mickkn/E2PRJ2/Projektrapport/Master.tex

\input{preamble_ida14}
\raggedbottom
\begin{document}

\include{filer/Underskrifter}

% Resume

\include{filer/resume}

% English Abstract

\include{filer/abstract}

% Indledning

\tableofcontents*

\include{filer/indledning}

% Opgave formulering

\include{filer/opgaveformulering}

% Afgrænsniger i projektet

\include{filer/projektafgraensning}

% Systembeskrivelse

\include{filer/systembeskrivelse}

% Kravspec

\include{filer/krav}

% generelle krav for systemet 

\include{filer/kravspec}

% Arbejdsprocessen

\include{filer/arbejdsproces}

% Udviklingsværktøjer

\include{filer/udviklingsvaerktoejer}

% Systemarkitektur

\include{filer/systemarkitektur}

%  Design - sections af HW og SW

\include{filer/design}

% Implementering - sections af HW og SW

\include{filer/implementering}

% Resultater

\include{filer/resultater}

% Resultater

\include{filer/erfaringer}

% Opnåede erfaringer som gruppe

\include{filer/fremtidigtarbejde}

% Konklusion

\include{filer/konklusion}

% Individuel Konklusion

\include{filer/Individuelkonklusion}

% Individuel Konklusion

% Litteraturliste
\include{filer/litteraturliste}

% Billags-CD struktur
\include{filer/cdindhold}

\end{document}
