mickkn/E2PRJ2/Projektrapport/filer/HWimplementering.tex

\section{Hardware implementering}

% HW implementering

Encoder og decoder er bygget på veroboard\footnote{Billeder af begge veroboard ses under integrationstesten i dokumentationen, side 106} ud fra kredsløbsdiagrammerne. Knappen til babyalarmen er tilføjet på encoder printet. 18 Vac / 50 Hz udtaget med tilhørende relæ er tilføjet på decoderprintet.
