mickkn/E2PRJ2/Projektrapport/filer/HWdesign.tex

\section{Hardwaredesign}

% HW design
Generelt kan det overordnede hardwaredesign beskrives som noget elektronik der sender information ud på el-nettet og modtages samt analyseres af noget elektronik i den anden ende. Disse vil blive beskrevet herunder som encoder og decoder\footnote{For yderlige beregninger se projektdokumentation side 67-75}.  

\section{Encoder (JS)}
X10-encoderen, er en del af CSS hovedenheden. CSS-hovedenheden genererer X10-bitstrømmen og sender den ud på det eksisterende el-net. Encoderen består af et højpasfilter der lader 120 kHz burst passere mens det blokerer for nettets 50 Hz signal, og en zero crossing detector der detekterer nulgennemgang.

\begin{figure}[htbp]
	\centering
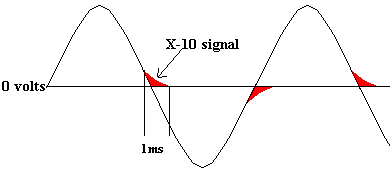
[picture p1: Projektrapport/Billeder/HWdesign/X10_BURST.png]
	
	\caption{120 kHz burst i zero crossing}
	\label{fig:X10_BURST}
\end{figure}

Ideen med at sende burst ud på nettet i zero crossing kan ses illustreret på figur \ref{fig:X10_BURST}

\begin{figure}[htbp]
	\centering
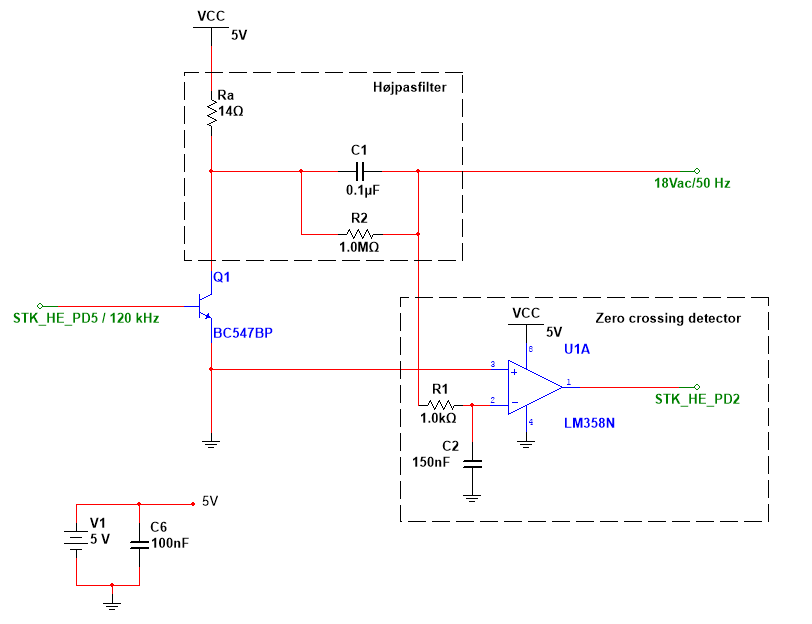
[picture p2: Projektrapport/Billeder/HWdesign/Encoder.PNG]
	
	\caption{Samlet Encoder}
	\label{fig:Encoder}
\end{figure}
\newpage

\subsection{Højpasfilter (JS)}

\begin{figure}[htb]
  \begin{minipage}{0.45\textwidth}
    \centering
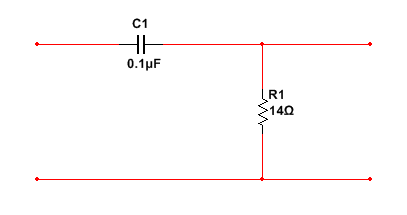
[picture p3: Projektrapport/Billeder/HWdesign/HP_MV.png]
      
      \caption{Højpasfilter med værdier}
    \label{fig:HP_MV}
  \end{minipage}
  \hspace{0.1\textwidth}
  \begin{minipage}{0.45\textwidth}
    \centering
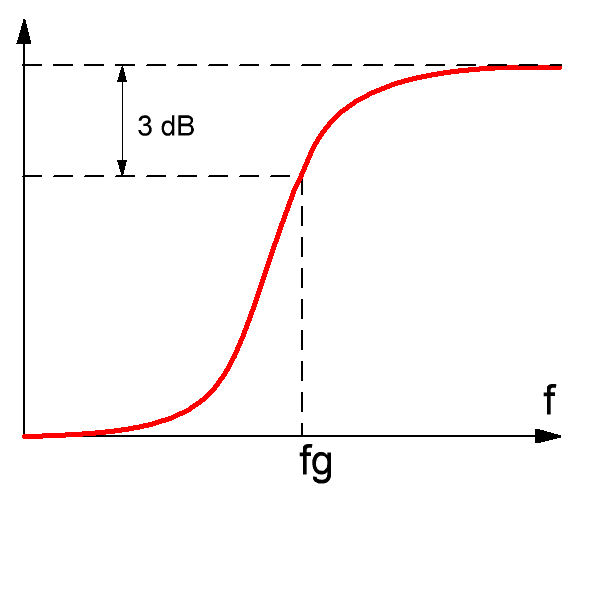
[picture p4: Projektrapport/Billeder/HWdesign/HP_KURVE.png]
      
      \caption{Kurvekarakteristik for højpasfilter}
    \label{fig:HP_KURVE}
  \end{minipage}
\end{figure}

For at sende X10 kommandoer ud på det eksisterende 50 Hz el-net er det nødvendigt at koble elektroniken direkte herpå og eftersom det elektronik ikke tåler de høje spændinger fra nettet, er det nødvendigt at blokere det signal, men stadig at kunne sende de 120 kHz ud. Dette løses med et højpasfilter.

Den ønskede knækfrekvens skal ligge omkring de 120 kHz for at opnå mindst dæmpning herpå. Ved denne knækfrekvens skulle 50 Hz signalet være ubetydelig lille efter filteret. 

Kondensatoren forudbestemmes via beregningerne til en værdi på 0,1 nF.

\newpage
  
\subsection{Zero Crossing Detector (SK)}
\begin{figure}[htb]
  \begin{minipage}{0.45\textwidth}
    \centering
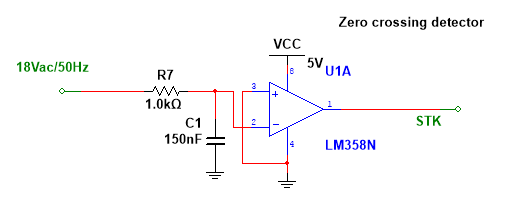
[picture p5: Projektrapport/Billeder/HWdesign/ZC_MV.PNG]
      
      \caption{Zero crossing detector med værdier}
    \label{fig:ZC_MV}
  \end{minipage}
  \hspace{0.1\textwidth}
  \begin{minipage}{0.45\textwidth}
    \centering
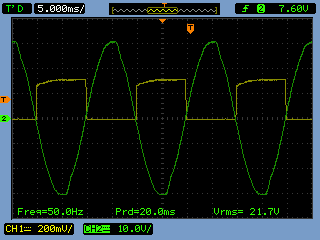
[picture p6: Projektrapport/Billeder/HWTest/Encoder/Encoder_zerocross.png]
      
      \caption{Scope billede af Zero crossing detector, CH1 (udgangssignal), CH2 (indgangssignal)}
    \label{fig:Encoder_Zerocross}
  \end{minipage}
\end{figure}

Zero crossing detectoren har til opgave at detektere nulgennemgang, det er et krav for at X10 protokollen kan virke. Der er placeret en zero crossing detector både på encoderen og decoderen, da begge disse består af et STK500-kit der kræver information om nulgennemgang. Opbygning kan ses på overstående figur \ref{fig:ZC_MV}, der er anvendt en operationsforstærker af typen LM358N, som toggler udgangssignalet ved hver nulgennemgang se figur \ref{fig:Encoder_Zerocross}. Operationsforstærkerens positive ben er koblet til stel for at lave et triggerniveau til 0 V.

Modstanden $R_7$ sidder der bl.a. for at beskytte zero crossing detectoren mod 18 Vac nettet, men sammen med kondensatoren udgør den også et lavpasfilter. Under implementeringen kunne det konstateres at der kom støj ind på zero crossing detectoren, og dette problem løste lavpasfilteret. 

Der ønskes at dæmpe 120 kHz signalet, derfor designes lavpasfilteret ud fra en knækfrekvens på 1,0 kHz.

\section{Decoder (JS)}
Decoderen, som er den del i systemet der omdanner burst fra encoderen til X10 kommando, er opbygget af et båndpasfilter, zero crossing detector og en envelope detector. I starten af kredsløbet sidder båndpasfilteret, og dette blokerer for el-nettet og forstærker 120 kHz signalet der kommer fra encoderen. Herefter ledes signalet gennem envelope detector som omdanner burstet til et TTL signal.

\begin{figure}[htbp]
	\centering
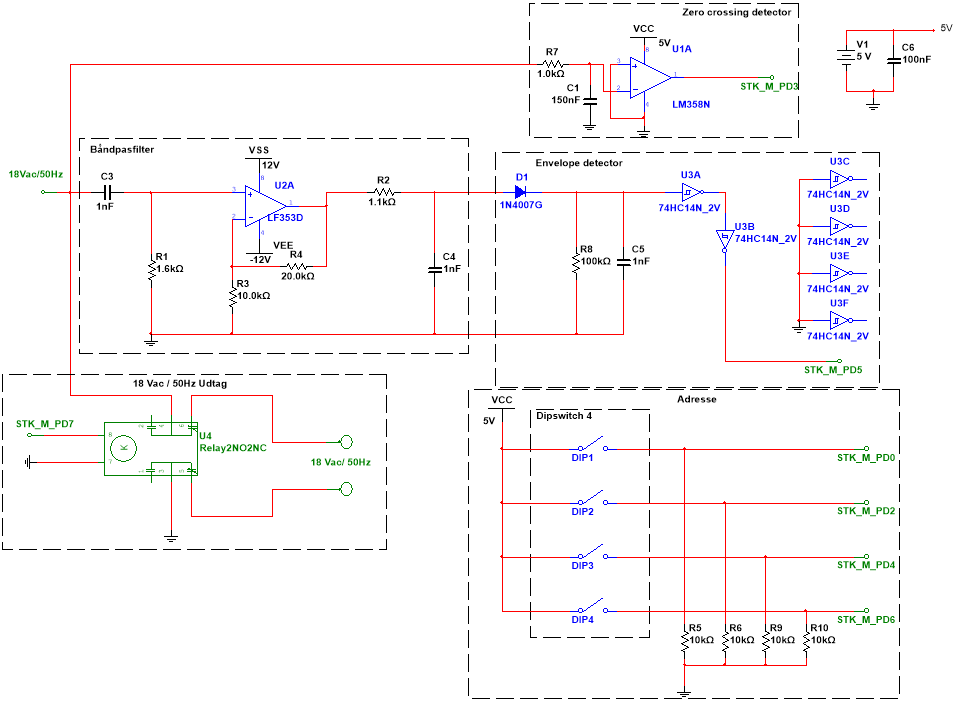
[picture p7: Projektrapport/Billeder/HWdesign/Decoder.PNG]
	
	\caption{Samlet Decoder}
	\label{fig:Decoder}
\end{figure}

\newpage

\subsection{Båndpasfilter (JS)}

\begin{figure}[htb]
  \begin{minipage}{0.45\textwidth}
    \centering
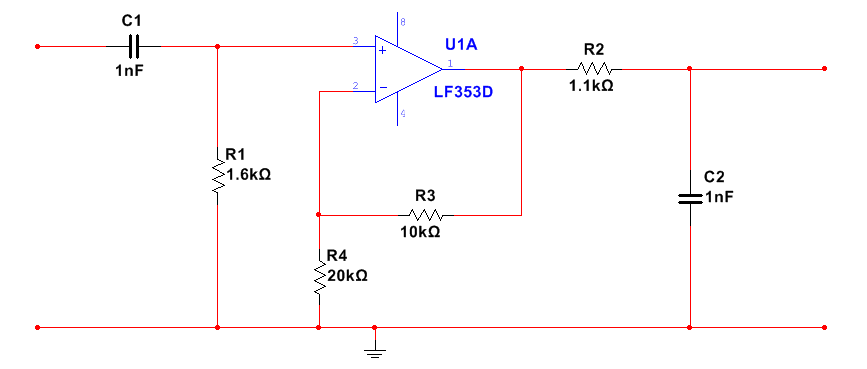
[picture p8: Projektrapport/Billeder/HWdesign/BAANDPAS_MV.PNG]
      
      \caption{Båndpasfilter med værdier}
    \label{fig:BAANDPAS_MV}
  \end{minipage}
  \hspace{0.1\textwidth}
  \begin{minipage}{0.45\textwidth}
    \centering
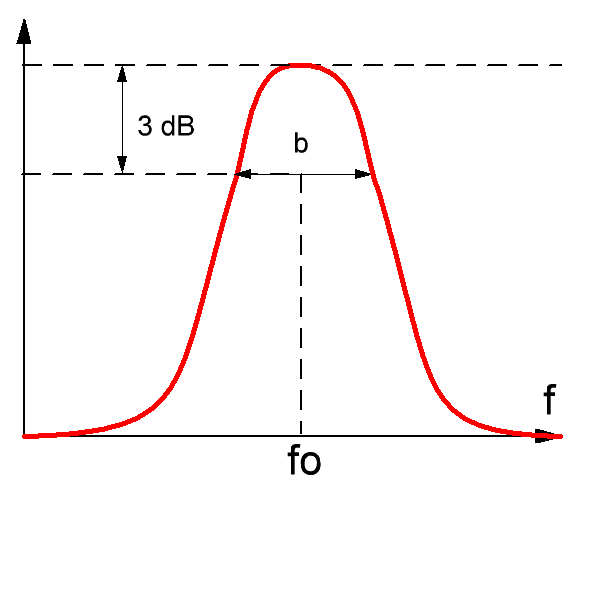
[picture p9: Projektrapport/Billeder/HWdesign/BAANDPAS_KURVE.png]
      
      \caption{Kurvekarakteristik for båndpasfilter}
    \label{fig:BAANDPAS_KURVE}
  \end{minipage}
\end{figure}

Båndpasfilteret har til opgave at filtrere alle signaler med frekvenser over og under 120 kHZ fra samtidig med at det forstærker signalet i båndpasset. Forstærkningen opnås ved at koble en ikke inverterende operationsforstærker med modstande forbundet på tilbagekoblingen, hvis størrelse afhænger af den ønskede forstærkning, mellem et højpasfilter og lavpasfilter som illustreret på figur \ref{fig:BAANDPAS_MV}. Kurvekarakteristikken er illustreret på figur \ref{fig:BAANDPAS_KURVE}.

Da vi ønsker at forstærke 120 kHz signalet, designes højpasfilteret således at knækfrekvensen udregnes til 110 kHz, og for lavpasfilteret beregnes en knækfrekvens til 130 kHz.

\subsection{Envelope Detector (SK)}
\begin{figure}[htbp]
	\centering
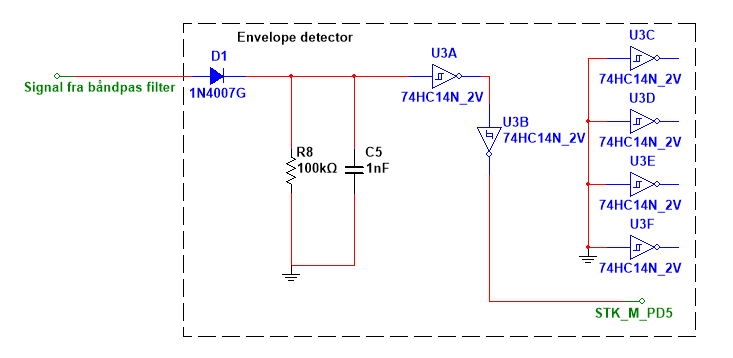
[picture p10: Projektrapport/Billeder/HWdesign/ED_MV.PNG]
	
	\caption{Envelope detector}
	\label{fig:ED_MV}
\end{figure}

Envelope detectorens opgave er at udglatte burstsignalet fra båndpasfilteret og lave det om til et TTL signal som STK500 kan aflæse.

Den er opbygget af en diode, et RC-led og en schmitt-trigger. Dioden har til opgave at sortere alle de negative halvperioder fra og kun sende de positive halvperioder til RC-leddet. Kondensatoren vil derfor kun opfange de positive halvperioder. Kondensatoren er med til at udglatte signalet da den ikke kan nå at aflades på en periode.

Modstanden $R_8$ er en afladnings modstand, og den bestemmer hvor hurtigt kredsløbet skal aflades, jo højere modstand jo langsommere går det med at aflade.

Der er anvendt en schmitt-trigger til at lave signalet om til et firkantet signal som STK500 kan aflæses. Grunden til at der er brugt 2 er fordi de er inverterende.

\newpage
\subsection{Dipswitch (JS)}
For at en X10-kommando bliver udført af det korrekte udtag medsendes en adresse på fire bit.
Til at angive den korrekte adresseringen for et udtag, er der lavet fire dipswitches der er forsynet med 5 V og forbundet til STK500 på X10-udtaget, som det er illustreret på figur \ref{fig:DIPSWITCH}.

En åben kontakt vil give LAV(0V) og en lukket kontakt vil resultere i HØJ(5V)

\begin{figure}[htbp]
	\centering
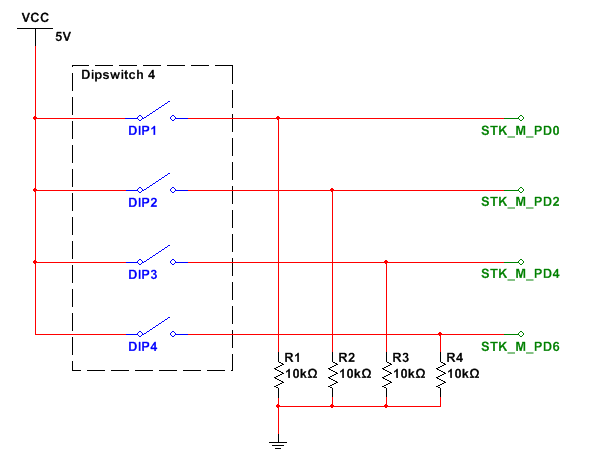
[picture p11: Projektrapport/Billeder/HWdesign/DIPSWITCH.PNG]
	
	\caption{Dipswitch for adressering af X10-udtag}
	\label{fig:DIPSWITCH}
\end{figure}
