mickkn/E2PRJ2/Projektrapport/filer/krav.tex

\chapter{Krav (JS)}
Child Security System er et system vi har udviklet med udgangspunkt i at gøre den almindelige husstand mere sikker for børn. Samtidig skal systemet have en integreret baby overvågning som er tiltænkt som erstatning for den almindelige babyalarm.
Via en hovedenhed styres udvalgte enheder, hvorfra disse kan slukkes og tændes. Disse enheder er almindelige 230 V udtag som ønskes at kunne afbrydes eller styre en magnetlås til aflåsning af døre eller skuffer.

Baby overvågningen består af en sensor der måler lydniveauet i et rum som sender et signal til hovedenheden hvis grænseværdien overskrides. Dette signal fortæller hovedenheden at den skal sende en SMS til et telefonnummer efter kundens ønske.
