mickkn/E2PRJ2/Projektdokumentation/filer/ordliste.tex

\chapter{Ordliste}

\begin{description}

\item[AC] Alternating Current (Vekselstrøm)
\item[API] Application Programming Interface (Softwaregrænseflade til SMS kommunikation)
\item[Carriage return] ASCII kommando for at returnerer cursoren. (Kommunikations protokollerne som ETX)
\item[CSS] Child Security System (Børnesikkerheds System)
\item[ETX] End of text (Seriel kommunikation)
\item[HMI] Human Machine Interface (Brugergrænseflade man kan interagere med)
\item[ISR] Interrupt Service Rutine (Microcontroller funktions kald i tilfælde af et interrupt signal)
\item[RS232] Recommended Standard 232 (Seriel digital datakommunikation)
\item[STK500] Atmel Mega32 development board
\item[STX] Start of text (Seriel kommunikation)
\item[UART] Universal Asynchronous Receiver/Transmitter
\item[UC] Use Case
\item[UI] User Interface (Brugergrænseflade)
\item[URL] Uniform resource locator (Adresse til internet resource)
\item[VAC] Volt Alternating Current (Vekselstrøm)
\item[X10] Kommunikationsprotokol over el-nettet

\end{description}
