mickkn/E2PRJ2/Projektdokumentation/filer/kravspec.tex

\chapter{Kravspecifikation}

\begin{table}[!htbp] \centering
\begin{tabular}{|p{2cm}|p{8cm}|}
	\hline
		\multicolumn{2}{|l|}{Versionshistorik} \\\hline
		\textbf{v1.2} &25-05-2014 Rettet ifm. accepttest\\\hline	
		\textbf{v1.1} &19-05-2014 Indledning + DE2 som aktør\\\hline
		\textbf{v1.0} &24-03-2014 Hele gruppen (efter 1. review)\\\hline
		\textbf{v0.5} &20-03-2014 Hele gruppen\\\hline
	\end{tabular}
\end{table}

\input{filer/indledning}

\begin{figure}[htbp] \centering
\section{Aktører}
\fbox{}
\caption{Kontekst diagram}
\label{lab:kontekstdiagram}
\end{figure}

\begin{table}[!htbp] \centering
\subsection{Bruger}
\begin{tabular}{|p{4cm}|p{8cm}|}
	\hline
		\textbf{Type Beskrivelse} &
			Bruger-aktøren er ejeren af systemet eller den voksne med adgang til PCen. 
			Vil typisk være forældre, barnepige osv. (Primær) \\\hline
	\end{tabular}
\end{table}

\begin{table}[!htbp] \centering
\subsection{Eksterne enheder}
\begin{tabular}{|p{4cm}|p{8cm}|}
	\hline
		\textbf{Type Beskrivelse} &
			Eksterne enheder, omfatter hvad man ønsker at aflåse eller slukke for. 
			Vil typisk være skabe, komfur, el-kedel osv. (Sekundær) \\\hline
	\end{tabular}
\end{table}

\begin{table}[!htbp] \centering
\subsection{Barn}
\begin{tabular}{|p{4cm}|p{8cm}|}
	\hline
		\textbf{Type Beskrivelse} &
			Barnet eller børnene i huset, som systemet skal beskytte.	(Sekundær) \\\hline
	\end{tabular}
\end{table}

\begin{table}[!htbp] \centering
\subsection{SMS-modtager}
\begin{tabular}{|p{4cm}|p{8cm}|}
	\hline
		\textbf{Type Beskrivelse} &
			Typisk forældrene eller barnepigen. Den person der skal have besked om gråd eller anden støj fra børneværelset. (Sekundær) \\\hline
	\end{tabular}
\end{table}

\begin{table}[!htbp] \centering
\subsection{DE2-board}
\begin{tabular}{|p{4cm}|p{8cm}|}
	\hline
		\textbf{Type Beskrivelse} &
			DE2-board programmeret som kodelås i DSD øvelse 7 (Sekundær) \\\hline
	\end{tabular}
\end{table}

\begin{figure}[!htbp] \centering
\section{Usecases}
\vspace*{\fill}

\caption{Usecase diagram}
\label{lab:usecasediagram}
\vspace*{\fill}
\end{figure}

\clearpage

% UC1: Login

\subsection{UC1: Login}
\input{filer/kravspec/uc1}

% UC2: Aktiver

\subsection{UC2: Aktiver}
\input{filer/kravspec/uc2}

% UC3: Deaktiver

\subsection{UC3: Deaktiver}
\input{filer/kravspec/uc3}

% UC4: Udlæs status

\subsection{UC4: Udlæs status}
\input{filer/kravspec/uc4}

% UC5: Detekter lyd

\subsection{UC5: Detekter lyd}
\input{filer/kravspec/uc5}

% UC6: Rediger SMS-modtager

\subsection{UC6: Rediger SMS-modtager}
\input{filer/kravspec/uc6}

% UC7: Startopsætning

\subsection{UC7: Startopsætning}
\input{filer/kravspec/uc7}

% UC8: Tilføj/fjern X10 udtag

\subsection{UC8: Tilføj/fjern X10 udtag}
\input{filer/kravspec/uc8}

%% Ikke-funktionelle krav

\section{Ikke-funktionelle krav}
\input{filer/kravspec/ikkefunktionellekrav}

%% Begrænsninger

\section{Begrænsninger} \label{sectionBegraensninger}
\begin{itemize}
	\item Prototypen udføres i et 18 Vac testmiljø
	\item I stedet for magnetlåse til at simulere låsemekanismen bruges en lysindikator
	\item Protypen udføres med et STK500-kit, hvorfor krav til dimensionerne frafalder
\end{itemize}

\newpage
\section{HMI(Human Machine Interface)}

Billederne er inverteret for læsbarhedens skyld.

\begin{figure}[H] \centering
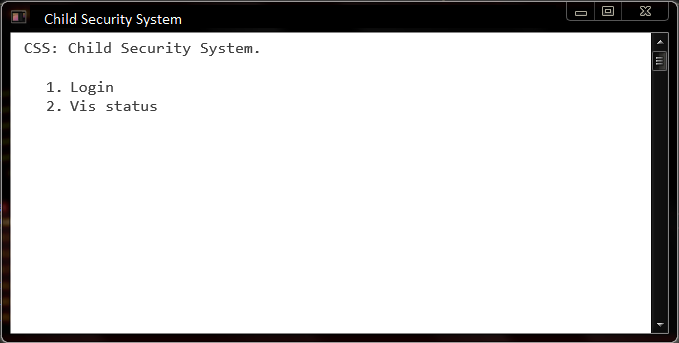
[picture p19: Projektdokumentation/billeder/cmdprompt/CSS_pre_login_menu.png]
{}
\caption{CSS Login skærm}
%\label{fig:CSS Login}
\end{figure}

\begin{figure}[H] \centering
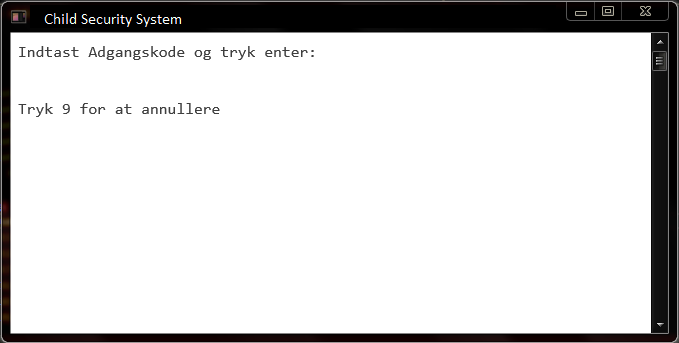
[picture p20: Projektdokumentation/billeder/cmdprompt/CSS_login.png]
{}
\caption{CSS Login}
%\label{fig:CSS Login}
\end{figure}

\begin{figure}[H] \centering
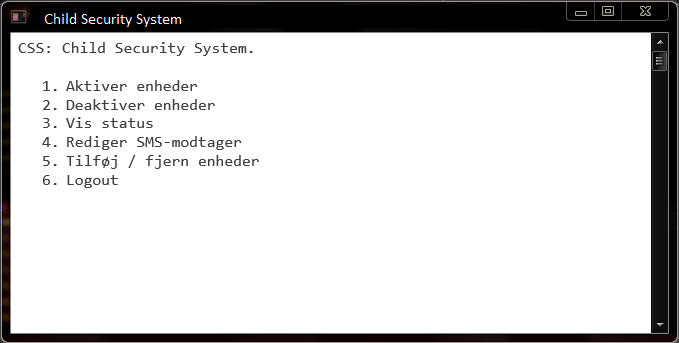
[picture p21: Projektdokumentation/billeder/cmdprompt/CSS_menu.png]
{}
\caption{CSS Menu}
%\label{lab:CSS Menu}
\end{figure}

\begin{figure}[H] \centering
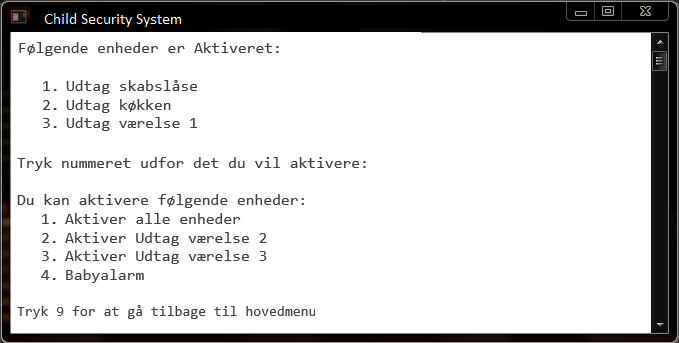
[picture p22: Projektdokumentation/billeder/cmdprompt/CSS_aktiver.png]
{}
\caption{CSS Aktiver}
%\label{fig:CSS Aktiver}
\end{figure}

\begin{figure}[H] \centering
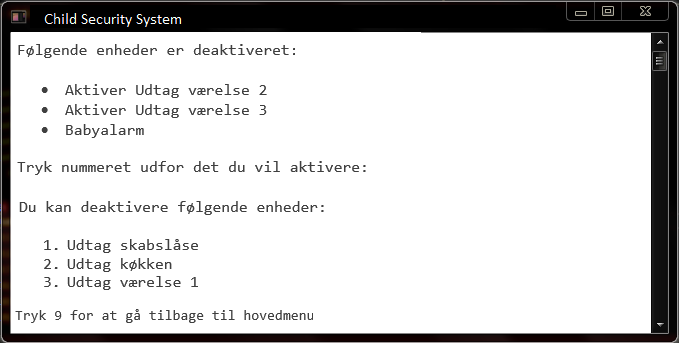
[picture p23: Projektdokumentation/billeder/cmdprompt/CSS_deaktiver.png]
{}
\caption{CSS Deaktvier}
%\label{fig:CSS Deaktvier}
\end{figure}

\begin{figure}[H] \centering
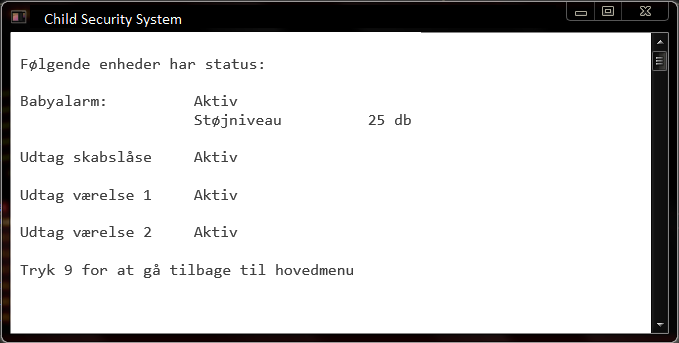
[picture p24: Projektdokumentation/billeder/cmdprompt/CSS_vis_status.png]
{}
\caption{CSS Udlæs status}
%\label{fig:CSS Vis Status}
\end{figure}

\begin{figure}[H] \centering
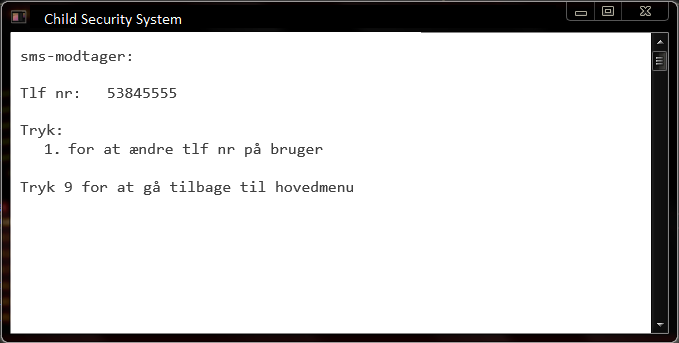
[picture p25: Projektdokumentation/billeder/cmdprompt/CSS_advisering.png]
{}
\caption{CSS Advisering}
%\label{fig:CSS Advisering}
\end{figure}
