mickkn/E2PRJ2/Projektdokumentation/filer/accepttest/atuc5.tex

%%% Tabel opsætning + Headernavn!!

\begin{center}
\begin{longtable}{|p{0,5cm}|p{3,8cm}|p{3,8cm}|p{2,2cm}|p{2,2cm}|} % l for left, c for center, r for right 
\hline
\multicolumn{5}{|l|}{\textbf{UC5: Detekter lyd}} \\ \hline
\multicolumn{1}{|c|}{} &
\textbf{Test} &
\textbf{Forventet \newline Resultat} &
\textbf{Resultat} &
\textbf{Godkendt/ \newline Kommentar} \\ \hline 
\endfirsthead

\multicolumn{5}{l}{...fortsat fra forrige side} \\ \hline 
\multicolumn{1}{|c|}{} &
\textbf{Test} &
\textbf{Forventet \newline Resultat} &
\textbf{Resultat} &
\textbf{Godkendt/ \newline Kommentar} \\ \hline 
\endhead

%%%% Tabel Opsætning

\textbf{1}		
&Lyddetektor er aktiveret
&Lyddetektor er aktiv	
&Ikke \newline testbart
&Ikke \newline godkendt \\\hline
\textbf{2}		
&Kontinuerligt lyd efterlignes	
&Detektorer opfanger lyd
&Ikke \newline testbart
&Ikke \newline godkendt \\\hline
\textbf{3}		
&Systemet underrettes	
&Systemet modtager signal fra lyddetektor 
&Som \newline forventet	
&Godkendt \newline vha. test kontakt  \\\hline
\textbf{4}		
&Systemet afsender SMS
&SMS-modtager modtager SMS fra systemet
&Som \newline forventet	
&Godkendt  \\\hline
	\end{longtable}
	%\caption{•}
	\label{ATUC5} 
\end{center}

%\begin{table}[htbp] \centering
%\begin{tabular}{|p{1,7cm}|p{2,3cm}|p{3cm}|p{3cm}|p{3cm}|} % l for left, c for center, r for right 
%	\hline
%\multicolumn{5}{|l|}{\textbf{UC7: Advisering}} \\\hline
%&\textbf{Test} &\textbf{Forventet \newline Resultat} &\textbf{Resultat} &\textbf{Godkendt/ \newline Kommentar} \\\hline
%\textbf{Punkt 1}		&Advisering vælges i interface	&Advisering screen kommer frem på skærmen 	&N/A 	&N/A \\\hline
%\textbf{Punkt 2}		&Der indtastes ændringer	og bekræftes		&Oplysningerne lagers i systemet og brugeren bliver sendt tilbage til menuen 	&N/A 	&N/A \\\hline
%	\end{tabular}
%	%\caption{•}
%	\label{ATUC7} 
%\end{table}
