mickkn/E2PRJ2/Projektdokumentation/filer/forundersoegelse/Laas.tex

\begin{table}[!h] \centering	
	\label{tab:laas1}
\begin{tabular}{|p{6cm}|p{8cm}|}
	\hline
		\textbf{Løsning}				&Elektrisk karm-lås TFS-A21 \\ \hline
		\textbf{Producent} 			&Ukendt \\ \hline
		\textbf{Tilslutning} 		&12VDC - 0.6A \\ \hline
		\textbf{Beskrivelse} 		&Elektrisk karm-lås med bevægelig pal \\ \hline
		\textbf{Krav} 				&Skal monteres med slutblæk \\ \hline
		\textbf{Fordele}				& \\ \hline
		\textbf{Ulemper} 			&Slutstykket begrænser montering (udfræsning). Den bevægelige pal skal smøres. \\ \hline
		\textbf{Pris} 				&65 kr \\ \hline
		\textbf{Link} 				&http://goo.gl/SDvjkd \\ \hline	
		\multicolumn{2}{|c|}{
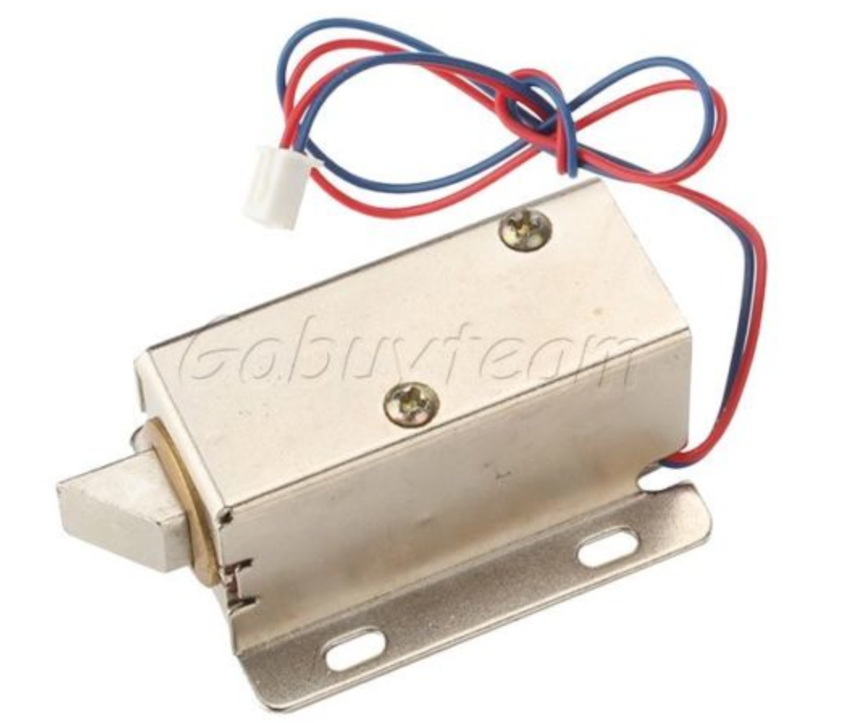
[picture p32: Projektdokumentation/billeder/TFS-A21.png]
			\raisebox{-0.91\height}{}} \\ \hline	
\end{tabular}
\end{table}

\begin{table}[!h] \centering
	\label{tab:laas2}
\begin{tabular}{|p{6cm}|p{8cm}|}
	\hline
		\textbf{Løsning}				&Elektromagnetisk lås 60kg \\ \hline
		\textbf{Producent} 			&KingGo \\ \hline
		\textbf{Tilslutning} 		&12 V DC - 0.3A\\ \hline
		\textbf{Beskrivelse} 		&Elektromagnetisk lås uden bevægelige dele \\ \hline
		\textbf{Krav} 				&Skal monteres med metalstykke \\ \hline
		\textbf{Fordele}				&Skal kun skrues fast \\ \hline
		\textbf{Ulemper} 			& \\ \hline
		\textbf{Pris} 				&115 kr \\ \hline
		\textbf{Link} 				&http://goo.gl/ewKYfa\\ \hline	
		\multicolumn{2}{|c|}{ 
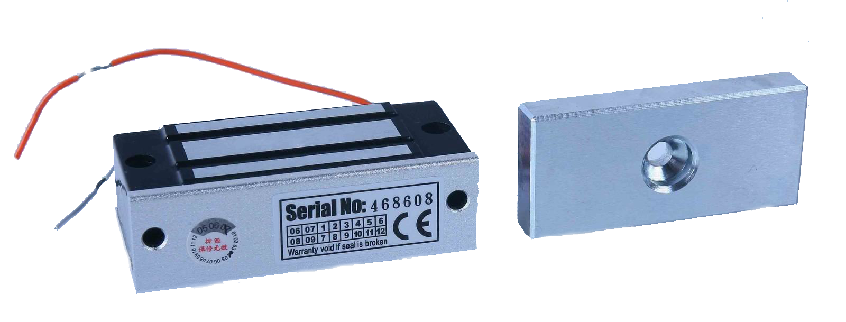
[picture p33: Projektdokumentation/billeder/magnetic.png]
			\raisebox{-0.91\height}{}} \\ \hline	
\end{tabular}
\end{table}
