mickkn/E2PRJ2/Projektdokumentation/filer/accepttest/accepttest.tex

\chapter{Accepttestspecifikation}

\begin{table}[!htbp] \centering
\begin{tabular}{|p{2cm}|p{8cm}|}
	\hline
		\multicolumn{2}{|l|}{Versionshistorik} \\ \hline
		\textbf{v1.0} &25-05-2014 Rettet ifm. med accepttest \\ \hline
		\textbf{v1.0} &24-03-2014 Hele gruppen (efter 1. review) \\ \hline
		\textbf{v0.5} &20-03-2014 Hele gruppen \\ \hline
	\end{tabular}
\end{table}

Punkterne i Accepttestspecifikationen, er skrevet ud fra punkterne i hovedforløbet, for de enkelte usecases.
Ved udførsel af accepttesten, bør UC\ref{ATUC7} laves først.

% Accepttest Use Case 1
\input{filer/accepttest/atuc1}

% Accepttest Use Case 2
\input{filer/accepttest/atuc2}

% Accepttest Use Case 3
\input{filer/accepttest/atuc3}

% Accepttest Use Case 4
\input{filer/accepttest/atuc4}

% Accepttest Use Case 5
\input{filer/accepttest/atuc5}

% Accepttest Use Case 6
\input{filer/accepttest/atuc6}

% Accepttest Use Case 7
\input{filer/accepttest/atuc7}

% Accepttest Use Case 8
\input{filer/accepttest/atuc8}

% Accepttest af ikke-funktionelle krav
\input{filer/accepttest/atikkefunktionellekrav}
