mickkn/E2PRJ2/Projektdokumentation/filer/forundersoegelse/Babyalarm.tex

\begin{table}[!h] \centering	
	\label{tab:baby1}
\begin{tabular}{|p{6cm}|p{8cm}|}
	\hline
		\textbf{Navn}				&Philips SCD505 \\ \hline
		\textbf{Rækkevidde} 			&330 \\ \hline
		\textbf{Lyd:} 				&Justerbar lydniveau. 
									Lys i forældreenheden angiver lydniveau ved babyen \\ \hline
		\textbf{Batteri} 		&Delvist genopladelig \\ \hline
		\textbf{Stråling} 				&Høj \\ \hline
		\textbf{Pris} 				&549 kr \\ \hline
		\textbf{Link} 				&http://goo.gl/pw06P9 \\ \hline	
		\multicolumn{2}{|c|}{
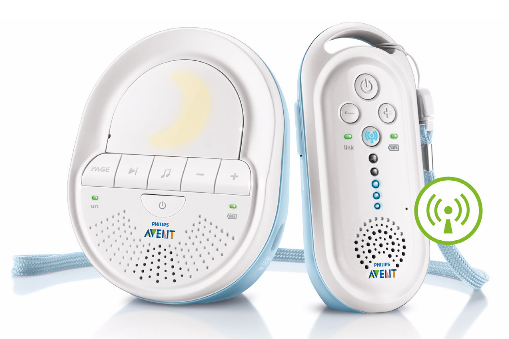
[picture p34: Projektdokumentation/billeder/SCD505.png]
			\raisebox{-0.91\height}{}} \\ \hline	
\end{tabular}
\end{table}

\begin{table}[!htbp] \centering
	\label{tab:baby2}
\begin{tabular}{|p{6cm}|p{8cm}|}
	\hline
		\textbf{Navn}				&Supernova D7 \\ \hline
		\textbf{Rækkevidde} 			&600m \\ \hline
		\textbf{Lyd} 		&Ukendt\\ \hline
		\textbf{Batteri} 		&2 genopladelige batterier \\ \hline
		\textbf{Pris} 				&999 kr \\ \hline
		\textbf{Stråling} 				&Lav \\ \hline
		\textbf{Link} 				&http://goo.gl/JFZcf5\\ \hline	
		\multicolumn{2}{|c|}{
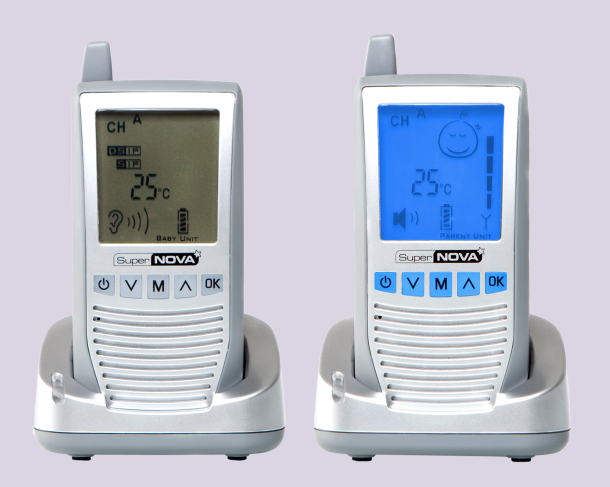
[picture p35: Projektdokumentation/billeder/Supernova.png]
			\raisebox{-0.91\height}{}} \\ \hline	
\end{tabular}
\end{table}
