mickkn/E2PRJ2/Projektdokumentation/filer/accepttest/atuc3.tex

%%% Tabel opsætning + Headernavn!!

\begin{center}
\begin{longtable}{|p{0,5cm}|p{3,8cm}|p{3,8cm}|p{2,2cm}|p{2,2cm}|} % l for left, c for center, r for right 
\hline
\multicolumn{5}{|l|}{\textbf{UC3: Deaktiver}} \\ \hline
\multicolumn{1}{|c|}{} &
\textbf{Test} &
\textbf{Forventet \newline Resultat} &
\textbf{Resultat} &
\textbf{Godkendt/ \newline Kommentar} \\ \hline 
\endfirsthead

\multicolumn{5}{l}{...fortsat fra forrige side} \\ \hline 
\multicolumn{1}{|c|}{} &
\textbf{Test} &
\textbf{Forventet \newline Resultat} &
\textbf{Resultat} &
\textbf{Godkendt/ \newline Kommentar} \\ \hline 
\endhead

%%%% Tabel Opsætning

\textbf{1}			&Bruger vælger ''Deaktiver'' i hovedmenu															
					&UI fortsætter til Punkt 2 (''Deaktiver menu'')
					&Som \newline forventet
					&Godkendt \\\hline
					
\textbf{2}			&Visuel test: Visning af ''Deaktiver menu''																
					&UI viser ''Deaktiver menu''
					&Som \newline forventet
					&Godkendt \\\hline

\textbf{3}			&''Deaktiver'' vælges			
					&UI fortsætter til Punkt 5 (Deaktivering)
					&Som \newline forventet
					&Godkendt \\\hline
					
\textbf{3a}			&''Tilbage'' vælges			
					&Fortsætter til Punkt 7 (Viser hovedmenu)
					&Som \newline forventet
					&Godkendt \\\hline

\textbf{4}			&Deaktivering			
					&Valgte enheder måles deaktiveret
					&Ikke \newline testbart 
					&Ikke \newline godkendt  \\\hline
		
\textbf{5}			&Visuel test: Viser besked om at enheder er deaktiverede
					&UI viser besked
					&Som \newline forventet
					&Godkendt \\\hline
					
\textbf{6}			&Visuel test: Viser hovedmenu
					&UI viser hovedmenu
					&Som \newline forventet
					&Godkendt \\\hline
					
%\textbf{Version}		&\multicolumn{4}{l|}{1.1} \\ \hline

	\end{longtable}
	%\caption{•}
	\label{ATUC3} 
\end{center}
