mickkn/E2PRJ2/Projektdokumentation/filer/accepttest/atuc4.tex

%%% Tabel opsætning + Headernavn!!

\begin{center}
\begin{longtable}{|p{0,5cm}|p{3,8cm}|p{3,8cm}|p{2,2cm}|p{2,2cm}|} % l for left, c for center, r for right 
\hline
\multicolumn{5}{|l|}{\textbf{UC4: Udlæs status}} \\ \hline
\multicolumn{1}{|c|}{} &
\textbf{Test} &
\textbf{Forventet \newline Resultat} &
\textbf{Resultat} &
\textbf{Godkendt/ \newline Kommentar} \\ \hline 
\endfirsthead

\multicolumn{5}{l}{...fortsat fra forrige side} \\ \hline 
\multicolumn{1}{|c|}{} &
\textbf{Test} &
\textbf{Forventet \newline Resultat} &
\textbf{Resultat} &
\textbf{Godkendt/ \newline Kommentar} \\ \hline 
\endhead

%%%% Tabel Opsætning

\textbf{1} 
&Vælger ''Udlæs status'' 
&UI fortsætter til Punkt 2 (Status vises) 
&Som \newline forventet
&Godkendt
 \\\hline

\textbf{2} &
Status vises &
Visuel: Status for systemet vises
&Som \newline forventet
&Godkendt
 \\\hline
\textbf{3} &
Vælg ''Tilbage'' fra status &
Visuel: Hovedmenu vises
&Som \newline forventet
&Godkendt
 \\\hline
	\end{longtable}
	%\caption{•}
	\label{ATUC4} 
\end{center}
