mickkn/E2PRJ2/Projektdokumentation/filer/accepttest/atuc6.tex

%%% Tabel opsætning + Headernavn!!

\begin{center}
\begin{longtable}{|p{0,5cm}|p{3,8cm}|p{3,8cm}|p{2,2cm}|p{2,2cm}|} % l for left, c for center, r for right 
\hline
\multicolumn{5}{|l|}{\textbf{UC6: Rediger SMS-modtager}} \\ \hline
\multicolumn{1}{|c|}{} &
\textbf{Test} &
\textbf{Forventet \newline Resultat} &
\textbf{Resultat} &
\textbf{Godkendt/ \newline Kommentar} \\ \hline 
\endfirsthead

\multicolumn{5}{l}{...fortsat fra forrige side} \\ \hline 
\multicolumn{1}{|c|}{} &
\textbf{Test} &
\textbf{Forventet \newline Resultat} &
\textbf{Resultat} &
\textbf{Godkendt/ \newline Kommentar} \\ \hline 
\endhead

%%%% Tabel Opsætning

\textbf{1} &
''Rediger SMS-modtager'' vælges i hovedmenu &
Menuen for ændring af SMS-bruger vises 
&Som \newline forventet
&Godkendt

 \\\hline

\textbf{2} &
Ændring fortages i SMS-modtagerens mobil nummer &
SMS-modtagerens mobil nummer opdateres i systemet
&Som \newline forventet
&Godkendt
 \\\hline

	\end{longtable}
	%\caption{•}
	\label{ATUC6} 
\end{center}
