mickkn/E2PRJ2/Projektdokumentation/filer/accepttest/atuc7.tex

%%% Tabel opsætning + Headernavn!!

\begin{center}
\begin{longtable}{|p{0,5cm}|p{3,8cm}|p{3,8cm}|p{2,2cm}|p{2,2cm}|} % l for left, c for center, r for right 
\hline
\multicolumn{5}{|l|}{\textbf{UC7: Startopsætning}} \\ \hline
\multicolumn{1}{|c|}{} &
\textbf{Test} &
\textbf{Forventet \newline Resultat} &
\textbf{Resultat} &
\textbf{Godkendt/ \newline Kommentar} \\ \hline 
\endfirsthead

\multicolumn{5}{l}{...fortsat fra forrige side} \\ \hline 
\multicolumn{1}{|c|}{} &
\textbf{Test} &
\textbf{Forventet \newline Resultat} &
\textbf{Resultat} &
\textbf{Godkendt/ \newline Kommentar} \\ \hline 
\endhead

%%%% Tabel Opsætning

\textbf{1} &
Indsæt serielt kommunikationskabel (RS232) i mellem computer og hovedenhedens COM-port\newline
Indsæt styrekabel mellem lyddetektor og hovedenheden\newline
Indsæt strømkabel mellem ledigt 230 Vac udtag og hovedenhedens AC indgang &
Visueltest: Alle kabler er forbundet korrekt 
&Som \newline forventet 
&Godkendt
 \\\hline

\textbf{2} &
Tænd hovedenhed og computer &
Visueltest: Systemet starter op inden for kravet på maksimalt 2 minutter
&Som \newline forventet 
&Godkendt
 \\\hline

\textbf{3} &
Start CSS programmet på computeren &
Visueltest: Programmet starter op og viser loginskærmen
&Som \newline forventet 
&Godkendt
 \\\hline

\textbf{4} &
En enhed opsættes ved at udføre accepttest af UC8 &
Den opsatte enhed er opsat korrekt
&Som \newline forventet 
&Godkendt
 \\\hline

\textbf{\ref{uc7sms}} &
SMS-modtager ændres ved at udføre accepttest af UC6 &
SMS-modtager er ændret
&Som \newline forventet 
&Godkendt
 \\\hline

	\end{longtable}
	%\caption{•}
	\label{ATUC7} 
\end{center}
