mickkn/E2PRJ2/Projektdokumentation/filer/accepttest/atuc1.tex

%%% Tabel opsætning + Headernavn!!

\begin{center}
\begin{longtable}{|p{0,5cm}|p{3,8cm}|p{3,8cm}|p{2,2cm}|p{2,2cm}|} % l for left, c for center, r for right 
\hline
\multicolumn{5}{|l|}{\textbf{UC1: Login}} \\ \hline
\multicolumn{1}{|c|}{} &
\textbf{Test} &
\textbf{Forventet \newline Resultat} &
\textbf{Resultat} &
\textbf{Godkendt/ \newline Kommentar} \\ \hline 
\endfirsthead

\multicolumn{5}{l}{...fortsat fra forrige side} \\ \hline 
\multicolumn{1}{c|}{} &
\textbf{Test} &
\textbf{Forventet \newline Resultat} &
\textbf{Resultat} &
\textbf{Godkendt/ \newline Kommentar} \\ \hline 
\endhead

%%%% Tabel Opsætning

\textbf{1}		
&Bruger vælger login i interfacet
&Login skærm kommer frem på skærmen 	
&Som \newline forventet	
&Godkendt \\\hline
\textbf{2.1}		
&På DE2 board indtastes koderne ''0001'', ''0011'' og ''0111'' adskilt af tryk på KEY0 
&Skærm ændres til hovedmenuen
&Som \newline forventet	
&Godkendt \\\hline
\textbf{2.2}		
&På DE2 board indtastes koderne ''0001'', ''0011'' og ''0110'' adskilt af tryk på KEY0 
&Skærm forbliver på login siden	
&Som \newline forventet	
&Godkendt \\\hline
\textbf{2a}		
&Bruger vælger annuller	
&Skærm går til login siden	
&Som \newline forventet	
&Godkendt \\\hline

\textbf{3}		
&Systemet validerer adgangskoden		
&Indtastede adgangskode valideres af systemtet 	
&Som \newline forventet	
&Godkendt \\\hline
\textbf{3a}		
&Systemet nægter adgang og beder bruger om at indtaste adgangskode igen	
&Indtastede adgangskode ikke valideret af systemet. Der bedes igen om adgangskode	
&Som \newline forventet	
&Godkendt \\\hline
\textbf{4}		
&Bruger får adgang til hovedmenuen		
&Hovedmenuen vises
&Som \newline forventet	
&Godkendt \\\hline
	\end{longtable}
	%\caption{•}
	\label{ATUC1} 
\end{center}
