mickkn/E2PRJ2/Projektrapport/filer/fremtidigtarbejde.tex

\chapter{Fremtidigt arbejde (SK)}

Et fremtidige arbejde kunne være at udarbejde de dele i projektet som ikke blev nået. Det er at få X10-udtaget til at fungere helt korrekt, samt at få lavet et mere kompakt design af vores print så det kunne implementeres lettere og mere enkelt. 

Lyddetektoren bliver aktiveret ved hjælp af en trykkontakt, et fremtidige arbejde kunne være at færdigudvikle denne. Der skulle laves kredsløbstegninger samt implementering og test. En udvikling af de beskrevet låsemekanismer skulle også udarbejdes for at der kunne leveres et komplet system.

Brugermenuen kunne udvikles med et smartere og mere brugervenlig design. Hvis systemet skulle leveres til andre lande end Danmark ville det være en fordel at der kunne vælges sprog, det gør at systemet kan sælges i større omfang. En app til smartphones kunne laves så der var mulighed for at betjene systemet fra andre steder end i hjemmet.
