mickkn/E2PRJ2/Projektrapport/filer/systemarkitektur.tex

\chapter{Systemarkitektur}

\section{Hardware arkitektur}

Følgende diagrammer viser hvordan hardwarearkitekturen er opbygget.\footnote{For yderligere BBD/IBD se projektdokumentation side 28-30.}

\begin{figure}[htbp] \centering
\section{Domænemodel}
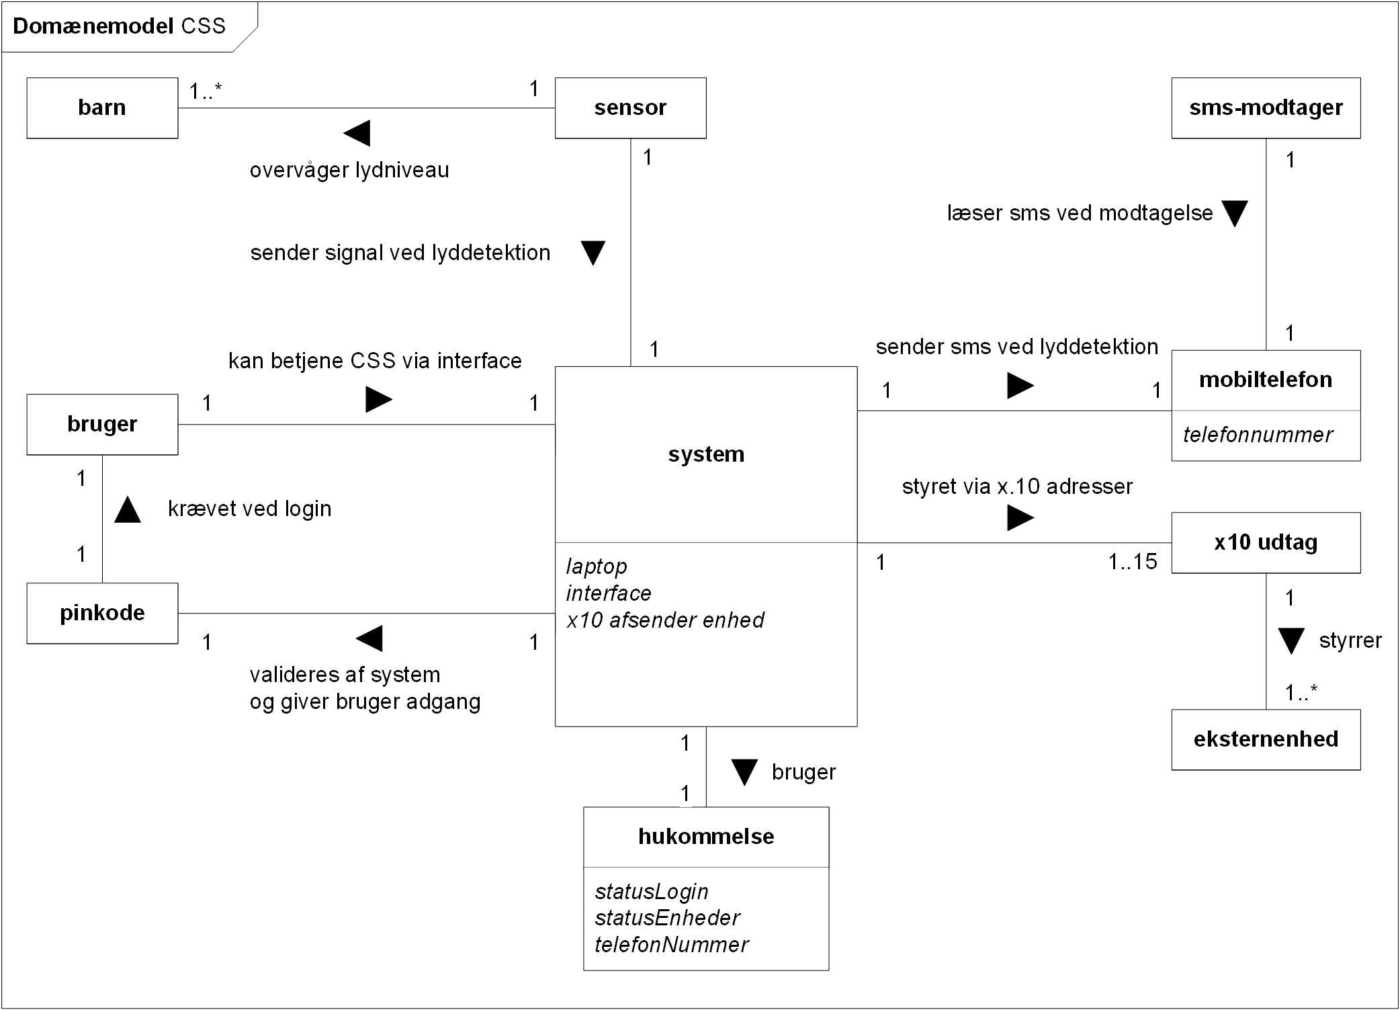
[picture p41: Projektrapport/Billeder/diagrammer/Domain_Model.png]
{}
\caption{Domænemodel}
\label{lab:domainmodel}
\end{figure}
Domænemodellen er udarbejdet i samarbejde med kunden. Denne har til opgave at give et struktureret billede af systemets funktionalitet og sammenhæng. Domænemodellen gør ikke brug af fagudtryk, men pile og kortfattede samt præcise sætninger anvendes for at beskrive sammenhængen mellem blokkene. Dette er med til at opnå en højere forståelse af systemet som helhed for kunden.

\newpage

\begin{figure}[!htbp] \centering
\subsection{BDD Hardware}
{}
\caption{BDD Hardware}
\label{lab:bddhardware}
\raggedright
\end{figure}
BDD diagrammet giver et overblik over hvad det samlede system består af. Her ses en portbeskrivelse som viser hvilke signaler hver blok består af.

\begin{figure}[!htbp] \centering
\subsection{Plantegning over HW}
{}
\caption{Plantegning over HW}
\label{lab:Plantegning over HW}
\raggedright
\end{figure}
Plantegningen over HW giver et overblik over hvordan CSS-hovedenheden og X10-udtaget er forbundet, samt hvilke type signaler der bliver sendt imellem dem.

\clearpage

\section{Software arkitektur}
\input{filer/SoftwareArkitektur}
