mickkn/E2PRJ2/Projektrapport/filer/arbejdsproces.tex

\chapter{Arbejdsproces}

\section{Udviklingsmodeller (JS, PO)}
Med udgangspunkt i ISE-undervisningen\footnote{Indledende System Engineering - ASE, fag på 2. semester} er projektarbejde opbygget omkring ASE-modellen som ses på figur \ref{fig:ASE_model}. ASE-modellen er opbygget i 2 faser. En fællesfase og en fagspecifik fase. 

\begin{figure}[htbp]
  \centering
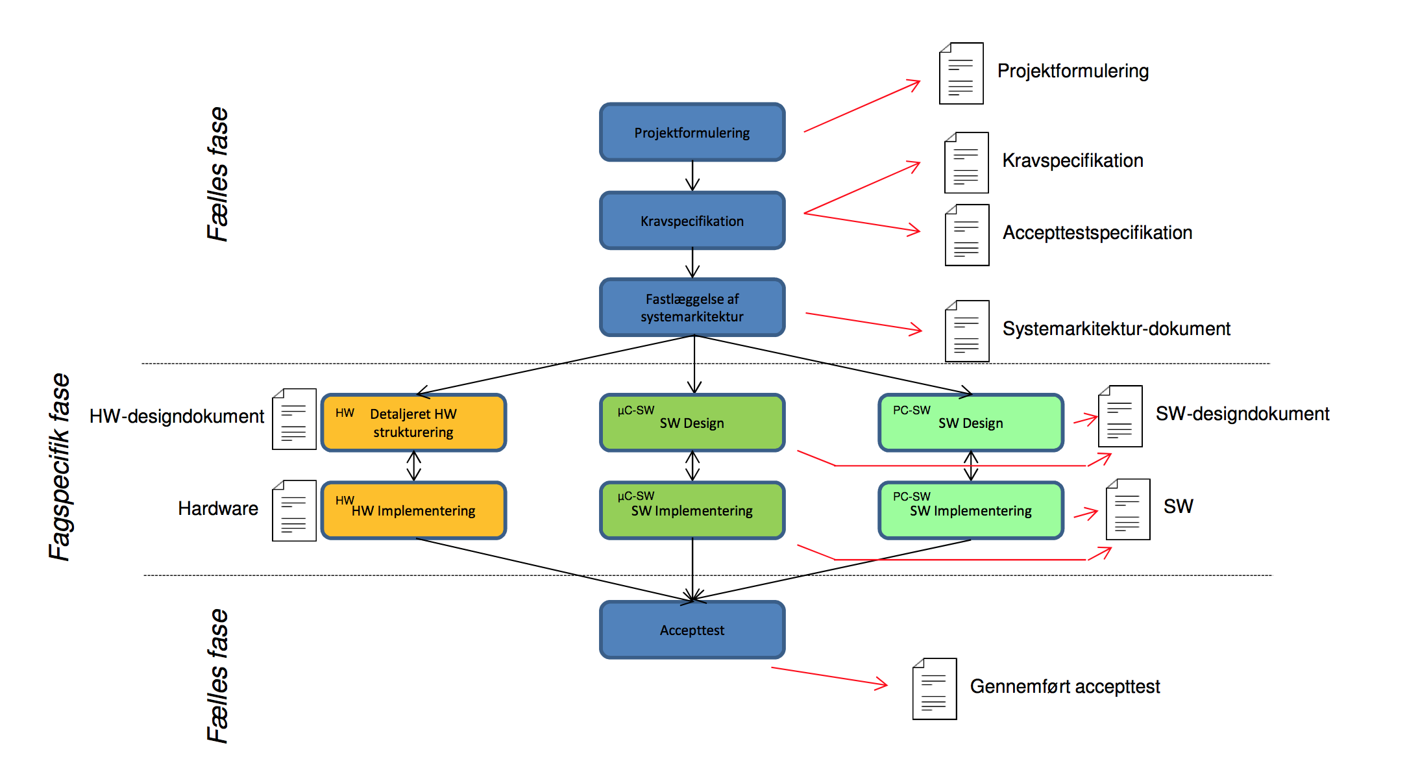
[picture p51: Projektrapport/Billeder/ASE-modellen.png]
    
    \caption{ASE-modellen}
    \label{fig:ASE_model}
\end{figure}

I fællesfasen arbejde hele gruppen sammen omkring udarbejdelse af de forskellige deldokumenter. 
I den fag specifikke fase deles gruppen op i mindre teams for at udvikle de fag specifikke deldokumenter. 

ASE-modellen tager udgangspunkt i V-modellen som ses på figur \ref{fig:V_model}.   

\begin{figure}[htbp]
  \centering
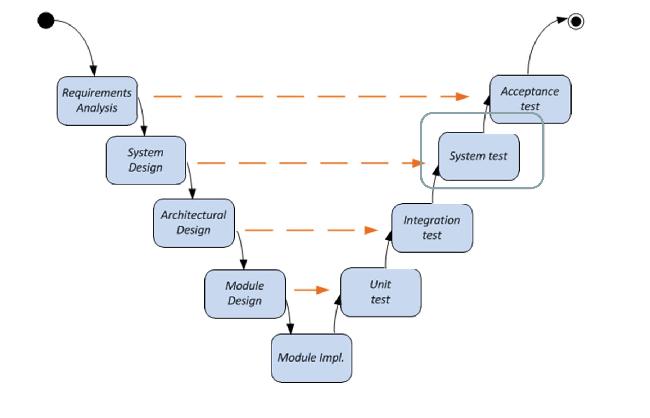
[picture p52: Projektrapport/Billeder/V-modellen.png]
    
    \caption{V-modellen}
    \label{fig:V_model}
\end{figure}

Ved at benytte V-modellens opbygning færdiggøres en fase inden en ny påbegyndes. Og ydermere planlægges testen af alle faserne parallelt med at fasen udarbejdes. F.eks udarbejdes accepttesten samtidigt med at kravespecifikationen udarbejdes.  

\section{Møder, tidsplan, logbog og referater (PO)}

I forbindelse med projektforløbet er der afholdt en række møder. Vejledermøder, gruppemøder samt reviewmøder.

Vejledermøder er forbindelsen mellem gruppen og gruppens vejleder. Her har det været muligt at få løbende feedback samt et indblik i om det der forventes også er det gruppen forventer. Vejledermøder har været fastlagt til ét i ugen. Det er næsten opretholdt, dog med enkelte aflysninger.

Gruppen har hver uge holdt mindst et, nogle gange flere møder. Disse møder er brugt til at afklare uoverensstemmelser og planlægning af den kommende uge. Under gruppemøderne er der 2 gange brugt tid på en trivsels runde. Her har det været muligt at give ris/ros til gruppen og eller enkelte gruppemedlemmer. Gruppemøderne startede lidt løst, men dette blev hurtigt ændret til at have en fast mødeholder, som styrede mødets gang. Tidsplanen er under gruppemøderne blevet revideret, således at den altid var opdateret til vejledermøderne. Gruppen har fra start udarbejdet en gruppekontrakt\footnote{Gruppekontrakten findes på bilags cd under navnet: Gruppekontrakt.pdf}. Gruppekontrakten har dannet grundlag for forventningerne til gruppen og dens medlemmer.

Reviewmøder har fungeret således at gruppen enten udførte review på en anden gruppe og herefter fremlagde dette. Omvendt modtog gruppen lignende review fra andre grupper. Disse review førte ofte til uklarheder, som gruppen herefter måtte tage stilling til i gruppemødet.

Alle møder blev ajour-ført med logbog og mødereferat. Her har gruppen haft en fast sekretær. 

\section{Arbejdsfordeling (PO)}
 
Kapitler og afsnit er angivet med forfatter, hvor gruppen ikke har været fællesforfatter. Oftest har der været flere om emnet, men kun én eller to forfattere. Derfor beskrives der herunder hvem der har haft hvilke arbejdsområder.  

Arbejdsfordelingen er herunder beskrevet. 

\subsection{Hardwareteamet (PO)} 
Hardwareteamet bestående af: Jakob, Mick, Poul og Simon. Samarbejde er nøgleordet for dette team.
Hele hardware teamet har deltaget på lige fod i den foranliggende proces mht. til arkitektur og design. Herefter har enkelte været forfattere på dele af hhv. rapport og dokumentation. Heraf ses at Jakob og Simon har stået for en del af indskrivningen, mens Mick og Poul har stået for implementeringen og den tilhørende test.
Vi har som team været samlet omkring fejlfinding af de enkelte moduler.  

\subsection{Softwareteamet (BS)}
Softwareteamet bestående af Bjørn, Jeppe og Jesper.
I den indledende fase af arkitekturen har software teamet arbejdet sammen, men forholdsvist hurtigt herefter delte teamet op i tre områder ud fra de hardware platforme der skulle programmeres på. Jesper har haft ansvar for PC, Bjørn for CSS-hovedenhed og Jeppe for X10-udtag. Jeppe har også lavet ClickATell klassen til PCen. Vi har arbejdet individuelt, men dog med regelmæssige møder og afklaring for at sikre at interface aftaler og lignende stadig blev overholdt.

\subsection{Andet (PO)}

Opsætning af \LaTeX, både dokumentation og rapport \newline
Hovedansvarlige: Mick, Poul 

Rettelse af projektdokumentation
Hovedansvarlig: Mick

Sekretærarbejde, bestående af logbog samt mødereferater \newline
Hovedansvarlig: Simon

Mødeleder, afholdelse af møder, status, samt tavlestyring \newline
Hovedansvarlig: Poul

Lokalebooking samt vejlederkontakt \newline
Hovedansvarlig: Jeppe
