mickkn/E2PRJ2/Projektrapport/filer/litteraturliste.tex

\chapter{Litteraturliste}

\section{Bøger}
AVR Microcontroller and Embedded Systems, Muhammad Ali Mazidi et al, Prentice Hall, 2014 \newline
C How to Program (7th Ed.), Paul Deitel \& Harvey Deitel, Pearson Education, 2013

\section{Hjemmesider}
Stack Overflow: http://www.stackoverflow.com/ [2014-05-27] \newline
Brugt som løsning og informationskilde ifm. implementeringen

\section{Opslagsværker}
Officiel C++ reference: http://www.cplusplus.com/ [2014-05-24] \newline
Opslagsværk til C++ standarden

UML-light, T-133, Finn Overgaard Hansen, IHA, Januar 2004 \newline
Summary from the Atmel Mega32 manual, T-495, Henning Hargaard, IHA, Juni 2011 \newline
