mickkn/E2PRJ2/Projektrapport/filer/cdindhold.tex

\chapter{Bilags-CD indhold}
Dette er en oversigt over filstrukturen på den vedlagt CD med bilag.

\begin{figure}[!htb]
	 \centering     
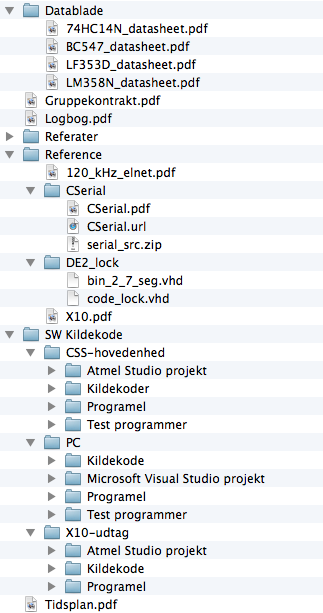
[picture p53: Projektrapport/Billeder/CD-filstruktur.png]
     {}
     \caption{Bilags-CD filstruktur}
     \label{fig:PC_package}
\end{figure}
