mickkn/E2PRJ2/Projektdokumentation/filer/systemarkitektur.tex

%
% System arkitektur
%
\chapter{System Arkitektur}

\begin{figure}[htbp] \centering
\section{Domænemodel (JS)}
{}
\caption{Domænemodel}
\label{lab:domainmodel}
\end{figure}
Domænemodellen er udarbejdet i samarbejde med kunden. Denne har til opgave at give et struktureret billede af systemets funktionalitet og sammenhæng. Domænemodellen gør ikke brug af fagudtryk, men pile og kortfattede, samt præcise sætninger anvendes, for at beskrive sammenhængene mellem blokkene. Dette er med til at opnå en højere forståelse af systemet som helhed, for kunden.

\newpage
%% Hardware
\section{Hardware beskrivelse}
\input{filer/HWbeskrivelse}

\clearpage
%% Software
\section{Software}

%%% Applikationsmodel for PC
\subsection{Applikations model for PC (JC)}
\input{filer/UML/applicationsmodel_pc}
\clearpage

%%%% Klasse beskrivelser
\subsection{Klassebeskrivelse for PC (JC)}
\input{filer/UML/UMLbeskrivelse_pc}
\newpage

%%% Applikationsmodel for CSS hovedenhed
\subsection{Applikations model for CSS-hovedenhed (BS)}
\input{filer/UML/applicationsmodel_css_hovedenhed}
\clearpage

%%%% Klasse diagram og beskrivelser
\subsection{Klassediagram og beskrivelse for CSS-hovednehed (BS)}
\input{filer/UML/UMLbeskrivelse_css_hovedenhed}
\newpage

\newpage
%%% Applikations model for X10 modtager
\subsection{Applikations model for X10-udtag (SW)}
\input{filer/UML/applicationsmodel_x10_udtag}
\clearpage

%%%% Klasse beskrivelser
\subsection{Klassebeskrivels for X10-udtag (BS)}
\input{filer/UML/UMLbeskrivelse_X10_udtag}
\newpage

%% Protokol
\section{Protokol}

%%% Seriel kommunikation
\subsection{Seriel kommunikation (BS)}
\input{filer/protokol/rs232}

%%% X10 kommunikation
\subsection{X10 kommunikation (BS)}
\input{filer/protokol/x10}
\newpage
