mickkn/E2PRJ2/Projektdokumentation/filer/SWBeskrivelse/DeploymentView.tex

\begin{figure}[!htb]
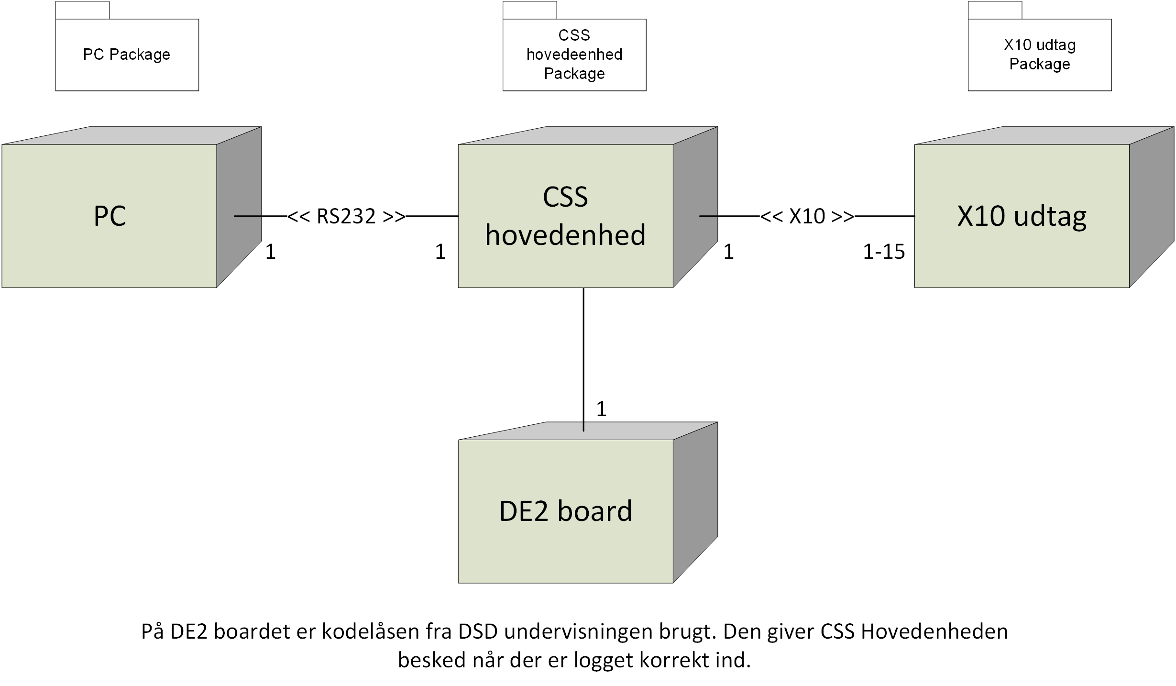
[picture p62: Projektdokumentation/billeder/UML/Deployment_model.png]
     {}
     \caption{Deployment View}
     \label{fig:Deployment model}
\end{figure}

Deployment View i figur \ref{fig:Deployment model} illustrerer forbindelserne imellem vores enheder og hvor de forskellige software pakker er placeret.

\begin{figure}[!htb]
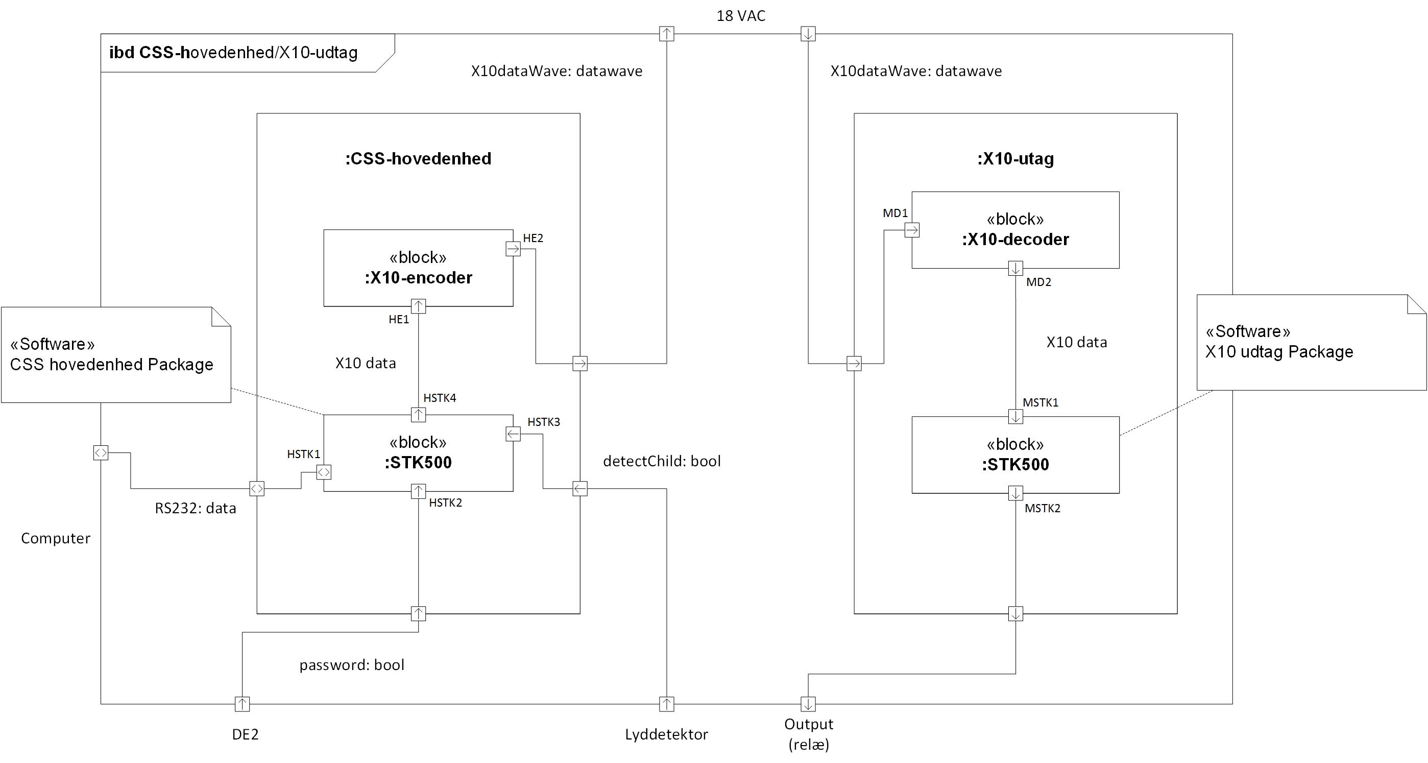
[picture p63: Projektdokumentation/billeder/UML/CSS_Hovedenhed_Modtager_deployment.png]
     {}
     \caption{IBD Deployment View for CSS-hovedenhed og X10-udtag }
     \label{fig:IBD Deployment model}
\end{figure}

Figur \ref{fig:IBD Deployment model} viser præcist hvor CSS-hovedenhed pakken og X10-udtag pakken er placeret. Pakkerne kan ses under Logical View. PC pakken er placeret på den PC som er koblet til CSS-hovedenheden via et RS232 kabel.
