mickkn/E2PRJ2/Projektdokumentation/filer/accepttest/atuc8.tex

%%% Tabel opsætning + Headernavn!!

\begin{center}
\begin{longtable}{|p{0,8cm}|p{3,8cm}|p{3,8cm}|p{2,0cm}|p{2,2cm}|} % l for left, c for center, r for right 
\hline
\multicolumn{5}{|l|}{\textbf{UC8: Tilføj/fjern X10 udtag}} \\ \hline
\multicolumn{1}{|c|}{} &
\textbf{Test} &
\textbf{Forventet \newline Resultat} &
\textbf{Resultat} &
\textbf{Godkendt/ \newline Kommentar} \\ \hline 
\endfirsthead

\multicolumn{5}{l}{...fortsat fra forrige side} \\ \hline 
\multicolumn{1}{|c|}{} &
\textbf{Test} &
\textbf{Forventet \newline Resultat} &
\textbf{Resultat} &
\textbf{Godkendt/ \newline Kommentar} \\ \hline 
\endhead

%%%% Tabel Opsætning

\textbf{1} &
Vælg menupunkt ''Tilføj / fjern enheder'' &
Visueltest: Programmet udskriver liste over i forvejen opsatte enheder
&Som \newline forventet 
&Godkendt
 \\\hline

\textbf{2a} &
Tast 2 og tryk ''Enter'' &
Visueltest: Programmet udskriver ''Navngiv venligst enheden''
&Som \newline forventet 
&Godkendt
 \\\hline

\textbf{2b} &
Indtast ''Test enhed'' efterfulgt af tryk på ''Enter'' knappen
&
&Som \newline forventet 
&Godkendt
 \\\hline

\textbf{2c} &
N/A & Visuel test: Programmet udskriver ''Angiv venligst valid adresse kode''
&Som \newline forventet 
&Godkendt
 \\\hline

\textbf{2d} &
Indstil X10 udtagets adresseswitch til adressen ''0101'' (1234) &
Visueltest: Adressen er indstillet
&Som \newline forventet 
&Godkendt
 \\\hline

\textbf{2e} &
Indtast adressen ''0101'' og tryk på ''Enter'' knappen &
N/A
& 
&
 \\\hline

\textbf{2e.a} &
Indtast adressen ''0'' og tryk på ''Enter'' knappen &
Visueltest: Programmet går til UC8.2.c
&Som \newline forventet 
&Godkendt
 \\\hline

\textbf{2f} &
N/A &
Visueltest: Programmet udskriver beskeden ''Enhed tilføjet'' og opdaterer listen med enheder
&Som \newline forventet 
&Godkendt
 \\\hline

\textbf{2g} &
Bruger tester UC2 og UC3 på opsatte enhed &
Visueltest: Enheden kan aktiveres og deaktiveres
&Ikke \newline testbart 
&Ikke \newline godkendt
 \\\hline

\textbf{3a} &
N/A &
Visueltest: Programmet udskriver beskeden ''Angiv hvilken enhed der skal fjernes''
&Som \newline forventet 
&Godkendt
 \\\hline

\textbf{3b} & 
Indtast 1 &
N/A &
 &\\\hline

\textbf{3c} & 
N/A &
Visueltest: Programmet udskriver beskeden ''Enhed fjernet'' og opdaterer listen med enheder
&Som \newline forventet 
&Godkendt\\\hline

\textbf{4a} & 
N/A &
Visueltest: Programmet viser hovedmenuen
&Som \newline forventet 
&Godkendt\\\hline

	\end{longtable}
	%\caption{•}
	\label{ATUC8} 
\end{center}
