mickkn/E2PRJ2/Projektdokumentation/filer/kravspec/uc4.tex

\begin{center} \centering
	\begin{longtable}{|p{6cm}|p{8cm}|}
	\hline
		\multicolumn{2}{|l|}{\textbf{UC4: Udlæs status}} \\\hline
		\endfirsthead
		
		\multicolumn{2}{l}{...fortsat fra forrige side} \\ \hline 
		\multicolumn{2}{|l|}{\textbf{UC4: Udlæs status}} \\\hline
		\endhead	
		
		\textbf{Mål}	&
			At udlæse status \\\hline
		\textbf{Initialisering} &
			Bruger vælger ''Udlæs status'' \\\hline
		\textbf{Aktører og Stakeholders} &
			Bruger(Primær) \\\hline
		\textbf{Referencer} &
			Ingen \\\hline
		\textbf{Antal af samtidige hændelser} &
			1 \\\hline
		\textbf{Forudsætning} &
			Systemet er tændt \\\hline
		\textbf{Efterfølgende tilstand} &
			Systemet viser hovedmenu \\\hline
		\textbf{Hovedforløb} &
		
		\begin{enumerate}
			\item Bruger vælger ''Udlæs status''
			\item Status vises
			\item Bruger vælger ''Tilbage''
		\end{enumerate} \\\hline
		
		\textbf{Undtagelser} &
			Ingen \\\hline
		%\textbf{Version}		&1.1 \\\hline
	\end{longtable}
	\label{UC4} 
\end{center}
