mickkn/E2PRJ2/Projektdokumentation/filer/kravspec/uc5.tex

\begin{center} \centering
	\begin{longtable}{|p{6cm}|p{8cm}|}
	\hline
		\multicolumn{2}{|l|}{\textbf{UC5: Detekter lyd}} \\\hline
		\endfirsthead
		
		\multicolumn{2}{l}{...fortsat fra forrige side} \\ \hline 
		\multicolumn{2}{|l|}{\textbf{UC5: Detekter lyd}} \\\hline
		\endhead	
		
		\textbf{Mål} &
			At underrette SMS-modtager ved lyddetektion \\\hline
		\textbf{Initialisering} &
			Barn\footnotemark afgiver lyd \\\hline
		\textbf{Aktører og Stakeholders} &
			SMS-modtager(Primær), Barn(Sekundær) \\\hline
		\textbf{Referencer}						
			&Ingen \\\hline
		\textbf{Antal af samtidige hændelser} &
			1 \\\hline
		\textbf{Forudsætning} & 
			At systemet er tændt og har forbindelse til internettet \\\hline
		\textbf{Efterfølgende tilstand} &
			Lyddetektor stadig aktiv \\\hline
		\textbf{Hovedforløb} &
			\begin{enumerate}

				\item Lyddetektor er aktiveret
												
				\item Lyddetektor detekterer lyd 
				
				\item Systemet underrettes
												
				\item Systemet afsender SMS
								
			\end{enumerate}\\\hline
	
		\textbf{Undtagelser} &
			Ingen \\\hline
			
		%\textbf{Version} &1.1 \\\hline
	\end{longtable}
	\label{UC5} 
\end{center}

\footnotetext{Grunden til at initialisering foretages af et Barn, er fordi at formålet med lyddetektoren er at fungere som babyalarm.} 

%\begin{table}[H] \centering
%\begin{tabular}{|p{6cm}|p{8cm}|}
%	\hline
%\multicolumn{2}{|l|}{\textbf{UC7: Advisering}} \\\hline
%\textbf{Mål}								
%&At brugeren kan opsætte/ændre systemets adviserings indstillinger
% \\\hline
%\textbf{Initialisering}					
%&Bruger vælger Advisering i interface
% \\\hline
%\textbf{Aktører og Stakeholders}			
%&Primær: Bruger Senkundær: SMS-bruger
% \\\hline
%\textbf{Referencer}						
%&Login
% \\\hline
%\textbf{Antal af samtidige hændelser}	
%&1
% \\\hline
%\textbf{Forudsætning}					
%&At interface er online
% \\\hline
%\textbf{Efterfølgende tilstand}			
%&Hovedmenu vises på skærmen.
% \\\hline
%\textbf{Hovedforløb}						
%& 
%\begin{enumerate}
%
%\item Bruger vælger advisering i interface
%
%\item Brugeren har mulighed for at se/ændre adviserings indstillinger
%
%\item Brugeren godkender
% 
%\end{enumerate}
% \\\hline
% 
%\textbf{Undtagelser} &Ingen \\\hline
%		\textbf{Version}		&1.0 \\\hline
%	\end{tabular}
%	\label{UC7} 
%\end{table}
