mickkn/E2PRJ2/Projektdokumentation/filer/kravspec/uc6.tex

\begin{center} \centering
	\begin{longtable}{|p{6cm}|p{8cm}|}
	\hline
		\multicolumn{2}{|l|}{\textbf{UC6: Rediger SMS-modtager}} \\\hline
		\endfirsthead
		
		\multicolumn{2}{l}{...fortsat fra forrige side} \\ \hline 
		\multicolumn{2}{|l|}{\textbf{UC6: Rediger SMS-modtager}} \\\hline
		\endhead	
		
\textbf{Mål} &
At bruger kan ændre SMS-modtager i systemet\\\hline

\textbf{Initialisering} &
Bruger vælger ''Rediger SMS-modtager'' \\\hline
 
\textbf{Aktører og Stakeholders} &
Bruger(Primær) \\\hline

\textbf{Referencer} &
UC1: Login  \\\hline

\textbf{Antal af samtidige hændelser} &
1  \\\hline

\textbf{Forudsætning} &
Bruger er logget ind (UC1: Login)\\\hline

\textbf{Efterfølgende tilstand} &
Hovedmenu vises  \\\hline

\textbf{Hovedforløb} &
\begin{enumerate}

\item Bruger vælger ''Rediger SMS-modtager''
\item \label{UC6und1}Bruger fortager ændringer af telefonnummer hvortil advisering sendes og bekræfter \newline
\textbf{[Undtagelse \ref{UC6und1}a]} Bruger vælger Annuller

\end{enumerate}   
 \\\hline
 
\textbf{Undtagelser}
&\begin{enumerate}[label= \ref{UC6und1}a.]
\item Bruger vælger annuller og kommer tilbage til hovedmenu
\end{enumerate}
 \\\hline
 
		%\textbf{Version}		&1.0 \\\hline

	\end{longtable}
	\label{UC6} 
\end{center}
