mickkn/E2PRJ2/Projektrapport/Projektrapport - Forside.pdf

+

# CSS

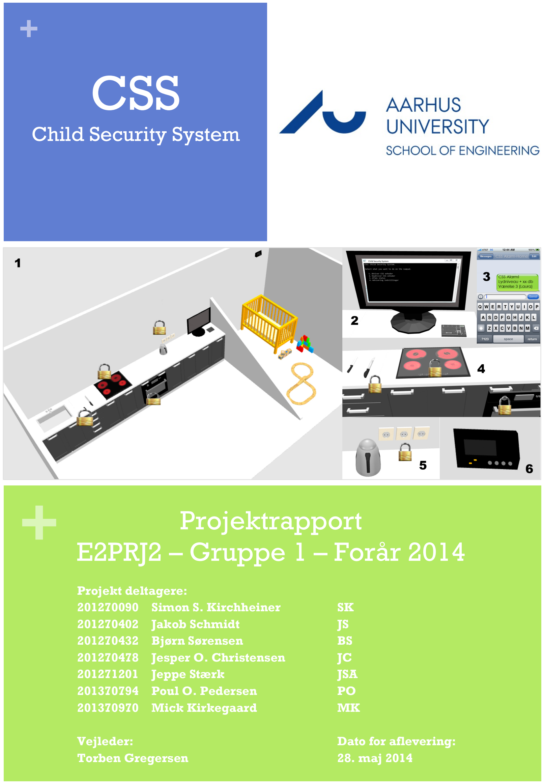
[picture p68: page 1]

+

## Child Security System

# Projektrapport E2PRJ2 – Gruppe 1 – Forår 2014

Projekt deltagere:
201270090 Simon S. Kirchheiner | SK
201270402 Jakob Schmidt | JS
201270432 Bjørn Sørensen | BS
201270478 Jesper O. Christensen | JC
201271201 Jeppe Stærk | JSA
201370794 Poul O. Pedersen | PO
201370970 Mick Kirkegaard | MK
Vejleder: | Dato for aflevering:
Torben Gregersen | 28. maj 2014
