mickkn/E2PRJ2/CD Root/Litteraturliste.pdf

# Litteraturliste 18

### 18.1 Bøger

AVR Microcontroller and Embedded Systems, Muhammad Ali Mazidi et al, Prentice Hall, 2014
C How to Program (7th Ed.), Paul Deitel & Harvey Deitel, Pearson Education, 2013

### 18.2 Hjemmesider

Stack Overflow: http://www.stackoverflow.com/ [2014-05-27]
Brugt som løsning og informationskilde ifm. implementeringen

### 18.3 Opslagsværker

Officiel C++ reference: http://www.cplusplus.com/ [2014-05-24]
Opslagsværk til C++ standarden
UML-light, T-133, Finn Overgaard Hansen, IHA, Januar 2004
Summary from the Atmel Mega32 manual, T-495, Henning Hargaard, IHA, Juni 2011

61
