mickkn/E2PRJ2/Projektdokumentation/Master.pdf

# Indholdsfortegnelse

Kapitel 1 Indledning | 3
Kapitel 2 Ordliste | 5
Kapitel 3 Kravspecifikation | 7
Kapitel 4 Forundersøgelse | 19
Kapitel 5 Accepttestspecifikation | 21
Kapitel 6 System Arkitektur | 31

# Indledning 1

Med udgangspunkt i børnesikkerhed i hjemmet vil vi udvikle et produkt, som kan hjælpe familier med børn, til at få et mere sikkert hjem.

Af problemerstillinger som kan opstå i en almindelig husholdning kan nævnes:

- Fare for at et barn tænder for en kogeplade, eller andre elektriske varme aggregater, og efterfølgende kan brænde sig
- Fare for at et barn kan skære sig på køkkenknive som ligger i en skuffe

Den anden del af systemet er en babyalarm. Næsten alle mennesker i Danmark har deres mobiltelefon i nærheden hele tiden, så i stedet for at skulle have en babyalarm med rundt også, så kan man koble sin mobil til systemet og få besked når barnet giver lyd fra sig.

Dette ender ud i tre produkter:

- Afbryder til valgt 230 Vac stikkontakt

Beskyttelse mod kogeplader og lignende
- Låsemekanisme til at låse skabe og skuffer

Aflåsning af skuffe med køkkenknive
- Babyalarm til lyddetektering

SMS-beskeder i stedet for en ekstra ”boks” i lommen

Systemet skal være nemt at sætte op og skal kommunikere over det eksisterende 230 V vekselspændings netværk i hus installationen.

En central enhed håndterer styringen i mellem enhederne og der skal være mulighed for at tilkoble en computer som kan bruges til at styre og aflæse systemet. Hele systemet kan aktiveres med et kodetryk.

Gruppe 1 | 1. Indledning

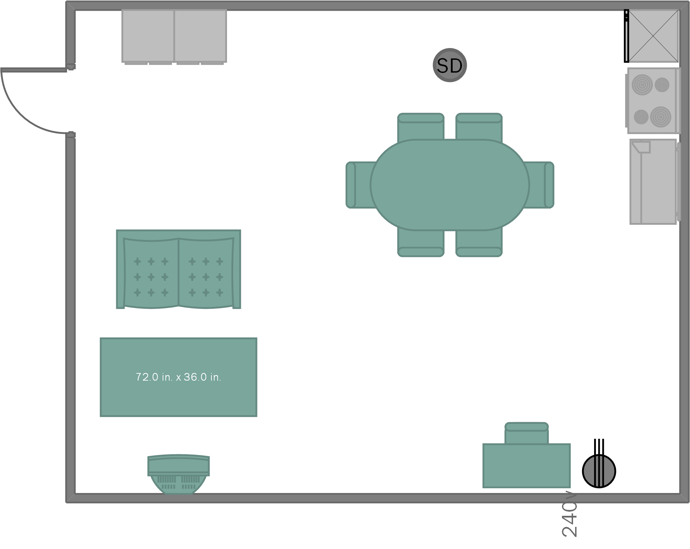
[picture p77: figure]

Figur 1.1. Plan tegning

# Ordliste 2

# Kravspecifikation 3

Versionshistorik
v1.0 | 24-03-2014 Hele gruppen (efter 1. review)
v0.5 | 20-03-2014 Hele gruppen

### 3.1 Aktører

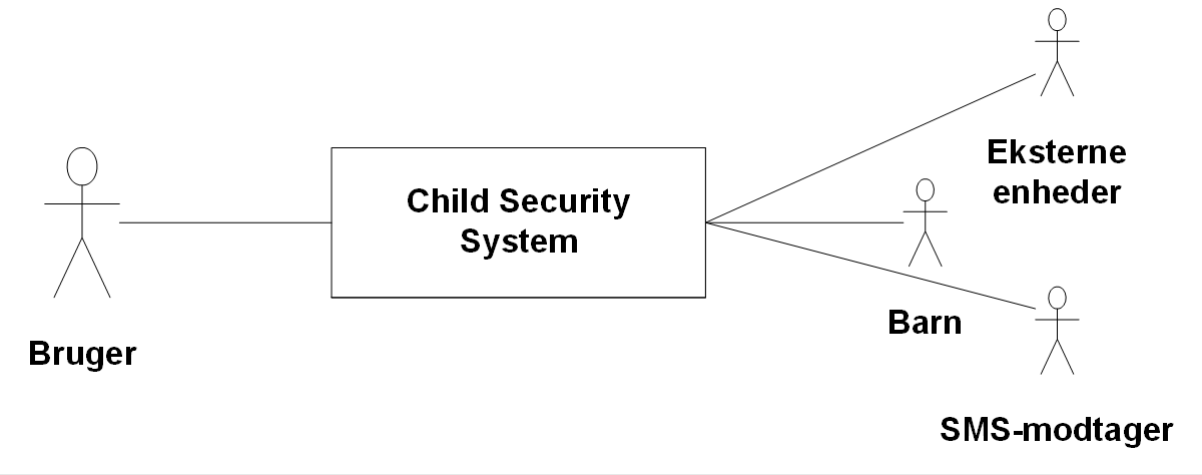
[picture p78: figure]

Figur 3.1. Kontekst diagram

### 3.1.1 Bruger

Type Beskrivelse | Bruger aktøren er ejeren af systemet eller den voksne med adgang til Computeren. Vil typisk være forældre, barnepige osv. (Primær)

### 3.1.2 Eksterne enheder

Type Beskrivelse | Eksterne enheder, omfatter hvad man ønsker at aflåse eller slukke for. Vil typisk være skabe, komfur, el-kedel osv. (Sekundær)

### 3.1.3 Barn

Type Beskrivelse | Barnet eller børnene i huset, som systemet skal beskytte. (Sekundær)

### 3.1.4 SMS modtager

Type Beskrivelse | Typisk forældrene eller barnepigen. Den person der skal have besked om gråd eller anden støj fra børneværelset. (Sekundær)

Gruppe 1 | 3. Kravspecifikation

### 3.2 Usecases

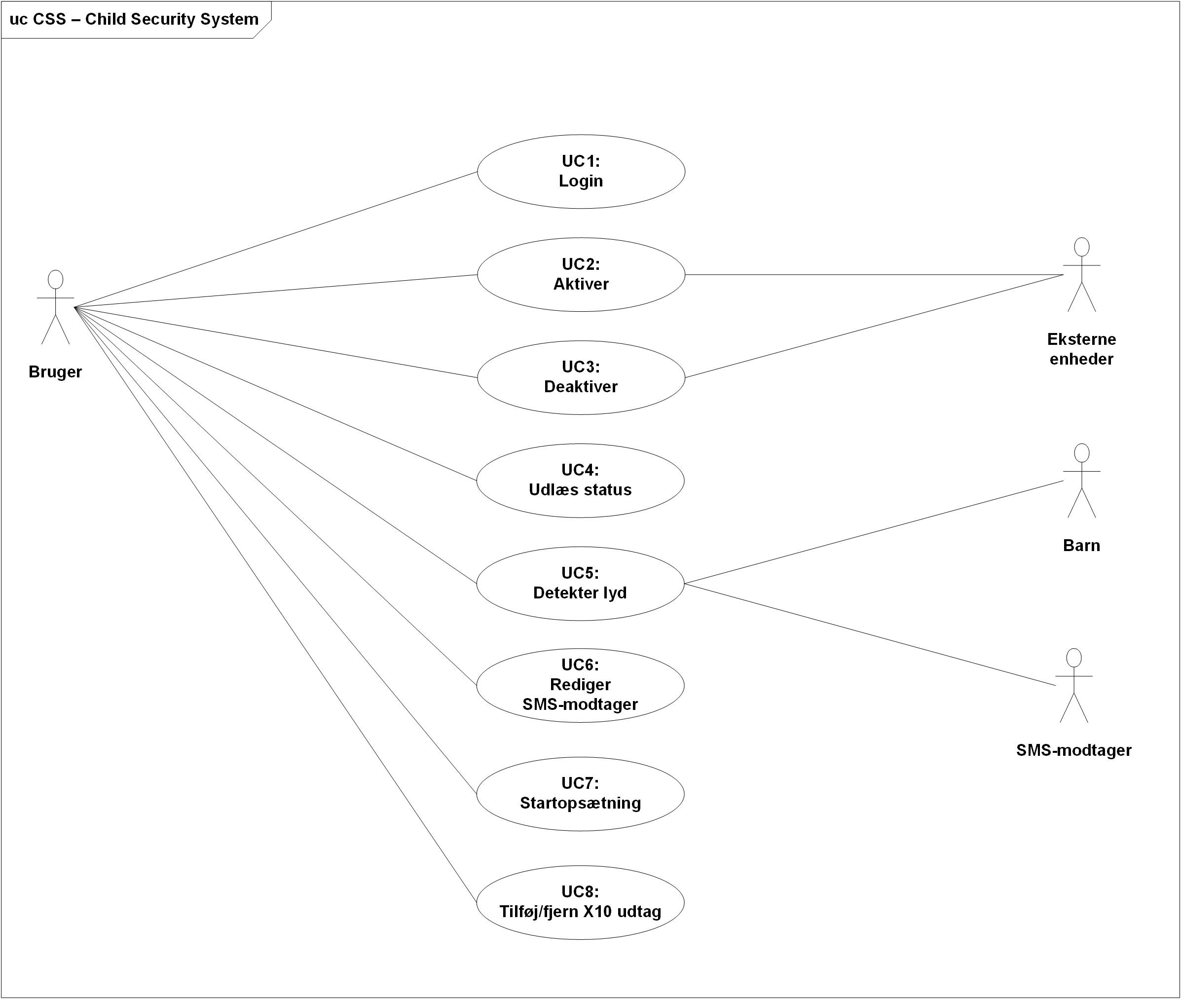
[picture p79: figure]

Figur 3.2. Usecase diagram

IHA - Aarhus Universitet

### 3.2.1 UC1: Login

Mål | At autoriseret bruger kan logge ind ved hjælp af adgangskode
Initialisering | Bruger vælger login i interface
Aktører og Stakeholders | Primær: Bruger
Referencer | Ingen
Antal af samtidige hændelser | Der kan fortages ét login ad gangen
Forudsætning | At interface er online
Efterfølgende tilstand | At bruger er logget ind og hovedmenu vises på skærmen. Hele systmet er klar til brug
Hovedforløb | 1. Bruger vælger login i interface 2. Bruger indtaster adgangskode [Undtagelse 1: Bruger vælger Annuller] 3. Systemet validerer adgangskode [Undta-gelse 2: Ikke valideret] 4. Bruger får adgang til hovedmenu
Undtagelser | 2a. Bruger vælger annuller og kommer tilbage til startskærm 3a. Adgangskode ikke indtastet korret. Ad-ganskode indtastes igen.

Gruppe 1 | 3. Kravspecifikation

### 3.2.2 UC2: Aktiver

Mål | At Bruger kan aktivere enkelte eller alle enheder, i systemet
Initialisering | Bruger vælger "Aktiver"
Aktører og Stakeholders | Bruger(Primær)
Referencer | UC1: Login
Antal af samtidige hændelser | 1
Forudsætning | Bruger er logget ind i systemet
Efterfølgende tilstand | Enkelte eller alle enheder er aktiveret
Hovedforløb | 1. Bruger logger ind med kode. 2. Bruger vælger ”Aktiver” i hovedmenu 3. UI viser mulige enheder samt ”Vælg alle”, ”Aktiver” og ”Tilbage” 4. Bruger markerer ønskede enheder til akti-vering 5. Bruger vælger ”Aktiver” [Undtagelse 5a] Bruger vælger ”Tilbage” 6. Systemet aktiverer valgte enheder [Undtagelse 6a] Ingen valgte enheder 7. UI viser besked om at enheder, er aktive-rede 8. UI returnerer til hovedmenu
Undtagelser | 1a. Bruger skal ikke logge ind 5a. UI returnerer til hovedmenu og UC2 afbrydes 6a. Hvis ingen unit er valgt udskrives en fejl på skærmen og beder brugeren om at vælge en unit og går til UC2.3

IHA - Aarhus Universitet

### 3.2.3 UC3: Deaktiver

Mål | At Bruger kan deaktivere enkelte eller alle enheder, i systemet.
Initialisering | Bruger vælger ”Deaktiver”
Aktører og Stakeholders | Bruger(Primær), Eksterne enheder(Sekundær)
Referencer | UC1: Login
Antal af samtidige hændelser | 1
Forudsætning | At systemet er helt eller delvist aktiveret.
Efterfølgende tilstand | Enkelte eller alle enheder er deaktiveret
Hovedforløb | 1. Bruger logger ind med kode. [Undtagelse 1a] Bruger ér logget ind 2. Bruger vælger "Deaktiver"i hovedmenu 3. UI viser mulige enheder samt ”Vælg alle”, ”Deaktiver” og ”Tilbage” 4. Bruger markerer ønskede enheder til deak-tivering 5. Bruger vælger "Deaktiver" [Undtagelse 5a] Bruger vælger ”Tilbage” 6. Systemet deaktiverer valgte enheder [Undtagelse 6a] Ingen valgte enheder 7. UI viser besked om at enheder, er deakti-verede 8. UI returnerer til hovedmenu
Undtagelser | 1a. Hovedmenu vises 5a. UI returnerer til hovedmenu og UC3 afbrydes 6a. Hvis ingen enheder er valgt udskrives en fejl på skærmen og beder brugeren om at vælge en enhed og går til UC3.3

Gruppe 1 | 3. Kravspecifikation

### 3.2.4 UC4: Udlæs status

Mål | Aflæse status
Initialisering | Brugeren vælger "Vis status”
Aktører og Stakeholders | Bruger(Primær)
Referencer | Ingen
Antal af samtidige hændelser | 1
Forudsætning | Systemet er tændt
Efterfølgende tilstand | Systemet viser hovedmenu
Hovedforløb | 1. Bruger vælger "Vis status" 2. Status vises 3. Bruger vælger tilbage
Undtagelser | Ingen

### 3.2.5 UC5: Detekter lyd

Mål | At detektere om barnet græder
Initialisering | Barnet
Aktører og Stakeholders | Bruger(Primær): Ønsker at kunne overvåge bar-net. SMS-modtager(Sekundær): Modtager SMS ved gråd. Barn(Sekundær): Ønskes overvåget
Referencer | Advisering
Antal af samtidige hændelser | 1
Forudsætning | At CSS er aktiveret, og advisering er opsat
Efterfølgende tilstand | Sensor stadig aktiv
Hovedforløb | 1. Systemet er aktiveret 2. Systemet detekter gråd 3. Systemet kalder advisering
Undtagelser | Ingen

IHA - Aarhus Universitet

### 3.2.6 UC6: Rediger SMS-modtager

Mål | At bruger kan ændre SMS-modtager i systemet
Initialisering | Bruger
Aktører og Stakeholders | Bruger(Primær): Ønsker at kunne ændre oplys-ninger på SMS-modtager
Referencer | Login
Antal af samtidige hændelser | 1
Forudsætning | At der er logget ind i systemet
Efterfølgende tilstand | Startskærm
Hovedforløb | 1. Bruger vælger "Rediger SMS-bruger" 2. Bruger fortager ændringer og bekræfter [Undtagelse 1: Bruger vælger Annul-ler]
Undtagelser | 2a. Bruger vælger annuller og kommer tilbage til startskærm

Gruppe 1 | 3. Kravspecifikation

### 3.2.7 UC7: Startopsætning

UC7: Startopsætning
Mål | At brugeren kan opsætte systemet første gang.
Initialisering | Bruger
Aktører og Stakeholders | Bruger(Primær): Ønsker at opsætte systemet første gang
Referencer | UC8 Tilføj/Fjern X10 udtag
Antal af samtidige hændelser | 1
Forudsætning | Ingen
Efterfølgende tilstand | Systemet er fuldt opsat
Hovedforløb | 1. Bruger sætter følgende kabler sammen: Serielt RS-232 kabel mellem hoveden-hedens COM-port og computer Medfølgende styrekabel til babyalarm forbindes med hovedenhed og babyalarm Strømkabel fra et ledigt 230 Vac udtag til hovedenhedens AC indgang 2. Bruger tænder for hovedenhed og compu-ter på Tænd/Sluk knappen 3. CSS programmet startes på computeren 4. UC8 Tilføj/fjern X10 udtag udføres 5. Punkt 4 gentages med antallet af X10 enheder der ønskes opsat

IHA - Aarhus Universitet

### 3.2.8 UC8: Tilføj/fjern X10 udtag

UC8: Tilføj/fjern X10 udtag
Mål | At brugeren kan opsætte en ny enhed med CSS
Initialisering | Bruger
Aktører og Stakeholders | Bruger(Primær): Ønsker at opsætte en ny enhed
Referencer | UC1: Login
Antal af samtidige hændelser | 1
Forudsætning | Ingen
Efterfølgende tilstand | En ny enhed er opsat med CSS
Hovedforløb
1. UC1: Login udføres
2. Bruger indstiller adresseswitchen til en unik adresse på X10 udtaget
3. Bruger vælger menupunkt ”Tilføj/fjern X10 udtag” og programmet udskriver beskeden ”Indtast den fire cifrede adresse”
4. Bruger indtaster den fire sifrede kombination som er indstillet på X10 udtaget efterfulgt af "enter"
[Undtagelse 4a] Adressen er ikke unik [Undtagelse 4b] Adressen har ikke den rette længde
5. Programmet udskriver beskeden "Indtast navn"
6. Bruger indtaster et selvvalgt navn for X10 udtaget efterfulgt af "enter"
[Undtagelse 6a] Navnet har ikke den rette længde
7. Programmet returnerer til hovedskærmen
8. Bruger sætter X10 udtaget i det ønskede 230 Vac udtag

Undtagelser
4a.1. Programmet udskriver fejlmeddellelsen "Adressen er ikke unik. Vælg en ny." 4a.2. Gå til UC8.2

4b.1. Programmet udskriver fejlmeddellelsen "Adressen har ikke den rette længde. Vælg en ny."
4b.2. Gå til UC8.2

6a.1. Programmet udskriver fejlmeddellelsen "Navnet skal minimum have to og maximum 50 karaktere"
6a.2. Gå til UC8.5

Gruppe 1 | 3. Kravspecifikation

### 3.3 Ikke-funktionelle krav

Brugbarhed (Usability)

1. UI skal kunne bruges efter gennemlæst manual.

Pålidelighed (Reliability)

2. Levetid: 5 år uden hardware nedbrud
3. Software oppetid: Minimum 1 måned før genstart

Ydeevne (Performance)

4. System respons må maksimalt være 2,5 sekunder
5. Startuptid fra power-off til funktionel tilstand maksimalt 2 minutter
6. Systemkapaciteten er på maksimalt 15 CSS udtag
7. Ved alarm må der maksimalt gå 1 minut før SMS advisering er afsendt

Vedligeholdelse (Supportability)

8. X10 udtag kan udskiftes separat ved simpel omkodning ved hjælp af adresseswitchen
9. Systemet er plug’n’play i en almindelig husholdning
10. X10 udtag kan tilføjes og installeres løbende

Generelle krav

11. Systemet skal virke på det eksisterende 230 Vac netværk i almindelige husstande
12. Kommunikationen mellem X10 udtag og hovedenheden skal ske på X10 protokollen
13. Systemet skal kunne afsende SMS adviseringer

CSS enheder

14. Udtag skal kunne være i en 1,5 moduls Fuga stikdåse
15. Udtag skal have en LED indikator som viser at den er aktiv
16. Hovedenheden skal kunne virke på 230 Vac/13 A tilslutning

Eksterne enheder

17. Lyddetektoren skal registrere lyde på over 68 dB
18. Låse enheder må maksimalt være 8x5x3 cm
19. Låse enhederne skal kunne holde 5 kilogram

### 3.4 Begrænsninger

- Prototypen udføres i et 18 Vac testmiljø
- I stedet for magnetlåse til at simulere låsemekanismen bruges en lysindikator
- Protypen udføres med et STK500 kit, hvorfor krav til dimensionerne frafalder

### 3.5 HMI(Human Machine Interface)

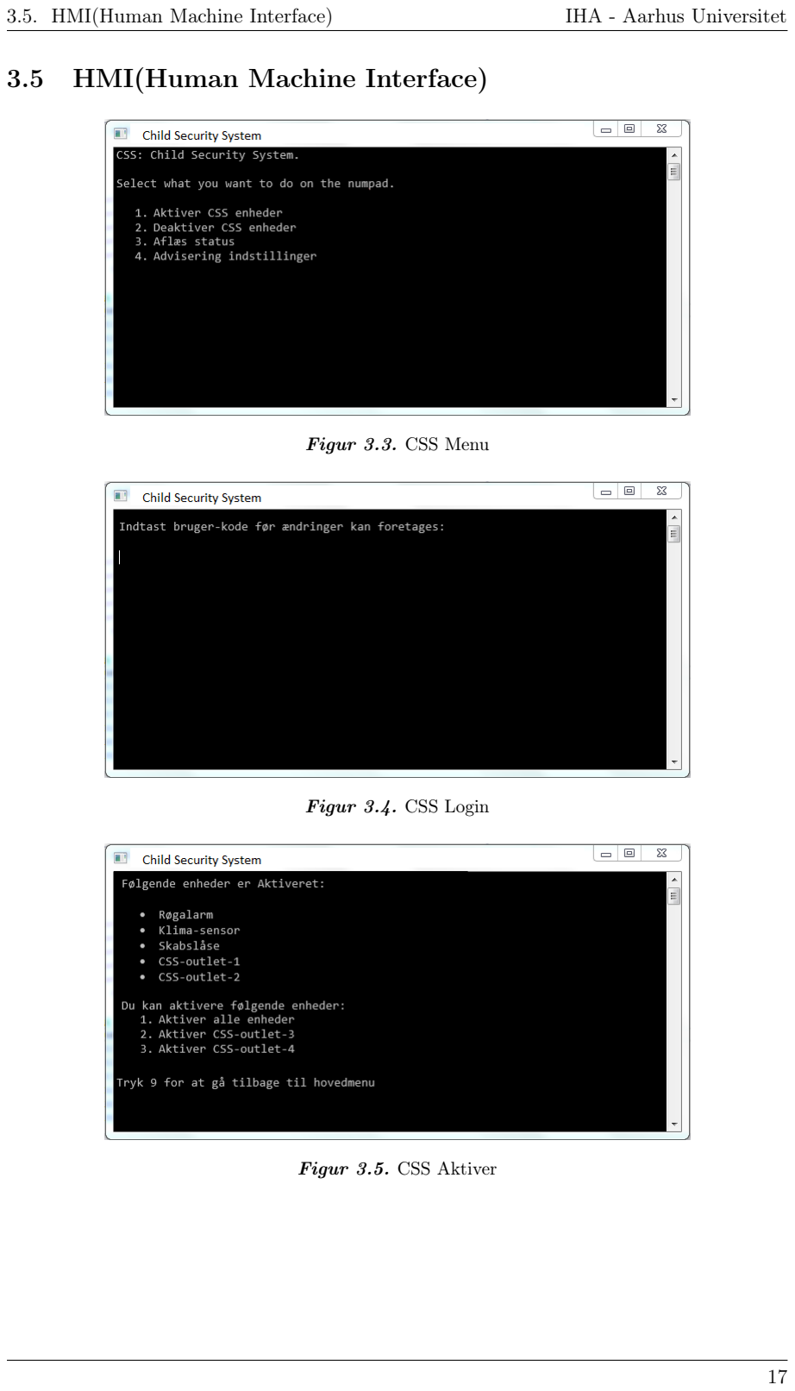
[picture p80: page 17]

3.5. HMI(Human Machine Interface) | IHA - Aarhus Universitet

Figur 3.3. CSS Menu

Figur 3.4. CSS Login

Figur 3.5. CSS Aktiver

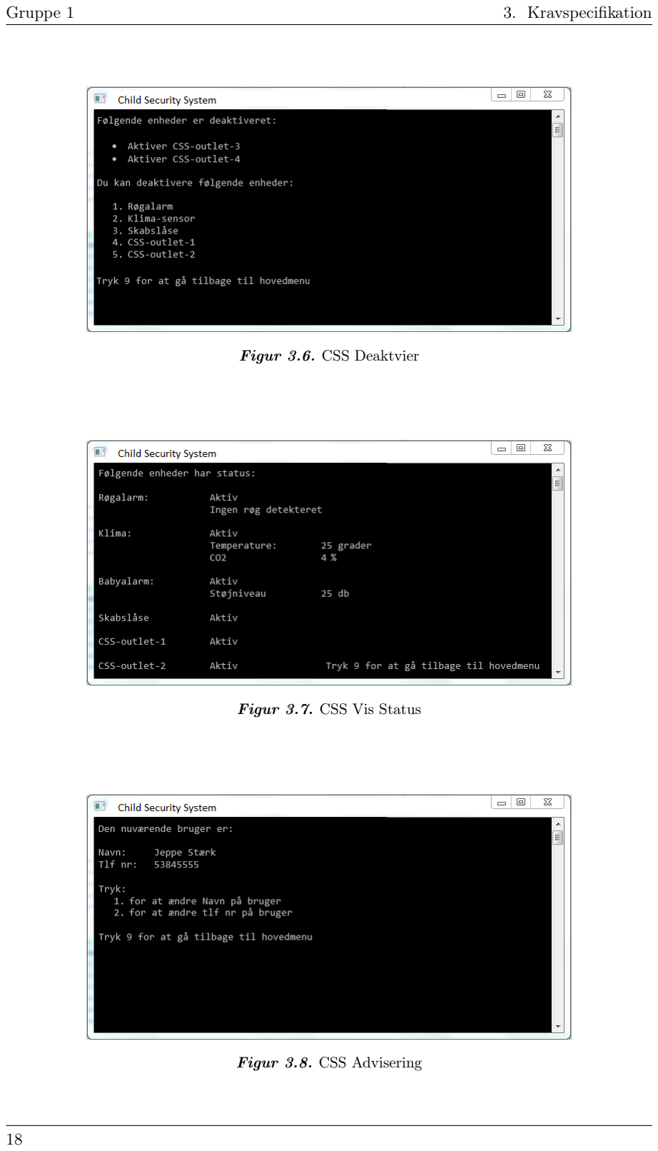
[picture p81: page 18]

Gruppe 1 | 3. Kravspecifikation

Figur 3.6. CSS Deaktvier

Figur 3.7. CSS Vis Status

Figur 3.8. CSS Advisering

# Forundersøgelse 4

### 4.0.1 GSM

Løsning | GSM Modul
Producent | Cinterion
Interface | I2C, SPI, USB
Beskrivelse | Hardware modul der kan tilkobles X10’eren via SPI
Krav | SIM kort og indgående programerings kendskab
Fordele | Mest pålidelige løsning og ingen forsinkelse på SMS’er
Ulemper | Kræver viden inden for Java eller Microsoft Windows Mobile programering
Pris | 563,23 - 656,34 + SMS takst
Link | http://dk.farnell.com/cinterion/mc75i/module-gsm-gprs-edge-quad-band/dp/1718875http://dk.farnell.com/cinterion/tc65i/mod-gsm-gprs-quad-band-tcp-ip/dp/1718877
Løsning | API
Producent | Clickctell
Interface | HTTP, HTTPS, FTP, SMPP, XML, SOAP, SMTP, COM obj.
Beskrivelse | Software baseret API modul
Krav | Forbindelse til internettet
Fordele | Let at programere
Ulemper | Kræver forbindelse til internettet
Pris | 0,762 kr. pr. SMS
Link | https://www.clickatell.com/apis-scripts/
Løsning | Arduino + GSM shield
Producent | Arduino
Interface | Internt
Beskrivelse | Single-board computer med GSM modul
Krav | SIM kort
Fordele | Let at programere
Ulemper
Pris | 149,- + 515,- + SMS takst
Link | http://arduino.cc/

# Accepttestspecifikation 5

Versionshistorik
v0.5 | 20-03-2014 Hele gruppen
v1.0 | 24-03-2014 Hele gruppen (efter 1. review)

Punkterne i Accepttestspecifikationen, er skrevet ud fra punkterne i hovedforløbet, for de enkelte usecases.

UC1: Login
| Test | Forventet Resultat | Resultat | Godkendt/ Kommentar
Punkt 1 | Login vælges i interface | Login screen kom-mer frem på skær-men | N/A | N/A
Punkt 2 | Login forsøg foretages medad-gangskoden: "1234" | Adgangskode ka-rakter vises som "****" | N/A | N/A
Punkt 3 | Systemet validerer ad-gangskoden | Indtastede ad-gangskode vailde-res af systemtet | N/A | N/A
Punkt 4 | Bruger får adgang til hovedmenu | Hovedmenu vises på skærmen og er klar til brug | N/A | N/A

UC2: Aktiver
| Test | Forventet Resultat | Resultat | Godkendt/ Kommentar
Punkt 1 | Bruger log-ger ind med kode | Testes i UC1: Login
Punkt 2 | Bruger væl-ger ”Aktiver” i hovedmenu | UI fortsætter til Punkt 3 (”Aktiver menu”) | N/A | N/A

Gruppe 1 | 5. Accepttestspecifikation

...fortsat fra forrige side
| Test | Forventet Resultat | Resultat | Godkendt/ Kommentar
Punkt 3 | Visuel test: Visning af ”Aktiver menu” | UI viser ”Aktiver menu” | N/A | N/A
Punkt 4a | ”Vælg alle” vælges | Alle enheder mar-keres på skærmen | N/A | N/A
Punkt 4b | Enkelte enheder vælges | De valgte ”enkel-te” enheder mar-keres på skærmen | N/A | N/A
Punkt 5 | ”Aktiver” vælges | UI fortsætter til Punkt 6 (Aktive-ring) | N/A | N/A
Punkt 5a | ”Tilbage” vælges | Fortsætter til Punkt 8 (Viser hovedmenu) | N/A | N/A
Punkt 6 | Aktivering | Valgte enheder måles aktiveret | N/A | N/A
Punkt 6a | Der væl-ges ingen enheder og trykkes "Aktiver" | UI udskriver fejl på skærmen med besked om at væl-ge en enhed og går til UC2.3 . Der måles ingen æn-dringer på enhe-derne | N/A | N/A
Punkt 7 | Visuel test: Viser be-sked om at enheder er aktiverede | UI viser besked | N/A | N/A
Punkt 8 | Visuel test: Viser hoved-menu | UI viser hovedme-nu | N/A | N/A

UC3: Deaktiver
| Test | Forventet Resultat | Resultat | Godkendt/ Kommentar
Punkt 1 | Bruger log-ger ind med kode | Testes i UC1: Login

IHA - Aarhus Universitet

...fortsat fra forrige side
| Test | Forventet Resultat | Resultat | Godkendt/ Kommentar
Punkt 2 | Bruger væl-ger ”Deakti-ver” i hoved-menu | UI fortsætter til Punkt 3 (”Deakti-ver menu”) | N/A | N/A
Punkt 3 | Visuel test: Visning af ”Deaktiver menu” | UI viser ”Deakti-ver menu” | N/A | N/A
Punkt 4a | ”Vælg alle” vælges | Alle enheder mar-keres på skærmen | N/A | N/A
Punkt 4b | Enkelte enheder vælges | De valgte ”enkel-te” enheder mar-keres på skærmen | N/A | N/A
Punkt 5 | ”Deaktiver” vælges | UI fortsætter til Punkt 6 (Deakti-vering) | N/A | N/A
Punkt 5a | ”Tilbage” vælges | Fortsætter til Punkt 8 (Viser hovedmenu) | N/A | N/A
Punkt 6 | Deaktivering | Valgte enheder måles deaktiveret | N/A | N/A
Punkt 6a | Der væl-ges ingen enheder og trykkes "Deaktiver" | UI udskriver fejl på skærmen med besked om at væl-ge en enhed og går til UC2.3 . Der måles ingen æn-dringer på enhe-derne | N/A | N/A
Punkt 7 | Visuel test: Viser be-sked om at enheder er deaktiverede | UI viser besked | N/A | N/A
Punkt 8 | Visuel test: Viser hoved-menu | UI viser hovedme-nu | N/A | N/A

Gruppe 1 | 5. Accepttestspecifikation

UC4: Udlæs status
| Test | Forventet Resultat | Resultat | Godkendt/ Kommentar
Punkt 1 | Vælger "Vis status" | Systemet viser status | N/A | N/A
Punkt 2 | Status vises | Visuel: Status for systemet vises | N/A | N/A
Punkt 3 | Vælg tilbage fra status | Visuel: Hovedme-nu vises | N/A | N/A

UC5: Detekter lyd
| Test | Forventet Resultat | Resultat | Godkendt/ Kommentar
Punkt 1 | Bruger aktiverer systemet via interface | System er aktivt | N/A | N/A
Punkt 2 | Kontinuerligt lyd efterlig-nes | Detektorer opfan-ger lyd og kalder advisering | N/A | N/A
Punkt 3 | SMS-modtager får tilsendt SMS | SMS-modtager får SMS med op-lyninger omkring barnegråd | N/A | N/A

UC6: Rediger SMS-modtager
| Test | Forventet Resultat | Resultat | Godkendt/ Kommentar
Punkt 1 | "Rediger SMS-bruger"vælges i interfecet | Skærmen for ændring af SMS-bruger vises | N/A | N/A
Punkt 2 | Ændring for-tages i SMS-brugeres mo-bil nummer | SMS-brugerens mobil nummer opdateres i syste-met | N/A | N/A

IHA - Aarhus Universitet

UC7: Startopsætning
Test | Forventet
Resultat
Resultat | Godkendt/
Kommentar
Punkt 1 Indsæt serielt kommunikationskabel
(RS232)
i mellem
computer
og hovedenhedens
COM-port
Indsæt styrekabel mellem
babyalarm
og hovedenheden
Indsæt
strømkabel
mellem ledigt 230 Vac
udtag og hovedenhedens
AC indgang

Visueltest: Alle
kabler er forbundet korrekt
N/A | N/A
Punkt 2 | Tænd hove-denhed og computer | Visueltest: Syste-met starter op in-den for kravet på maksimalt 2 mi-nutter | N/A | N/A
Punkt 3 | Start CSS programmet på compute-ren | Visueltest: Pro-grammet starter op og viser hoved-skærmen | N/A | N/A
Punkt 4 | En enhed opsættes ved at udføre accepttest af UC8 | Den opsatte en-hed er opsat kor-rekt | N/A | N/A

Gruppe 1 | 5. Accepttestspecifikation

UC8: Tilføj/fjern X10 udtag
Punkt | Test | Forventet Resultat | Resultat | Godkendt/ Kommentar
1 Se accepttest | af UC1 | Bruger er logget ind og kan se ho-vedskærmen | N/A | N/A
2 | Indstil X10 udtagets adres-seswitch til adres-sen ”0101” (1234) | Visueltest: Adres-sen er indstillet korrekt | N/A | N/A
3 | Vælg me-nupunkt ”Tilføj/fjern X10 udtag” | Visueltest: Pro-grammet ud-skriver beskeden ”Indtast den fire cifrede adresse” | N/A | N/A
4 Indtast | adressen ”0101” og tryk på ”en-ter” knappen | ?? | N/A | N/A
4a | Indtast adressen ”0000” og tryk på ”en-ter” knappen | Programmet ud-skriver fejlbeske-den og går til UC8.2 | N/A | N/A
4b | Indtast adressen ”0” og tryk på ”enter” knappen | Visueltest: Pro-grammet udskri-ver fejlbeskeden og går til UC8.2 | N/A | N/A
5 | N/A | Visueltest: Pro-grammet ud-skriver beskeden ”Indtast navn” | N/A | N/A
6 Indtast ”Test | enhed” og tryk på ”en-ter” knappen | ?? | N/A | N/A

IHA - Aarhus Universitet

...fortsat fra forrige side
Punkt | Test | Forventet Resultat | Resultat | Godkendt/ Kommentar
6a | Indtast ”A” og tryk på ”enter” knap-pen. Gentag med ”abcdefghi-jklmnopqr-stuvxwabc-defghijklm-nopqrstu-vxwab | Visueltest: Pro-grammet udskri-ver fejlbeskeden og går til UC8.2 | N/A | N/A
7 | N/A | Visueltest: Pro-grammet re-turnerer til hovedskærmen | N/A | N/A
8 Indsæt X10 | udtag i et 230 Vac udtag som er forbundet til systemet og kør ac-cepttest af UC2 på den nyopsatte enhed | Det er muligt at styre det opsat-te X10 udtag ved brug af UC2 og UC3 | N/A | N/A

Ikke-funktionelle krav
Punkt | Test | Forventet Resultat | Resultat | Godkendt/ Kommentar
1 Udenforstående | bruger gen-nemlæser manualen og opsætter systemet med et X10 udtag | Brugeren har ikke problemer med opsætningen og brugen af systemet | N/A | N/A
2 | Ikke testbart | N/A | N/A | N/A
3 | Ikke testbart | N/A | N/A | N/A

Gruppe 1 | 5. Accepttestspecifikation

...fortsat fra forrige side
Punkt | Test | Forventet Resultat | Resultat | Godkendt/ Kommentar
4 Systemet | antages som værende fuldt opsat. Bruger akti-verer et X10 udtag iht. UC2 Aktiver og kontrol-lerer tiden fra ”Aktiver” er valgt til enhenden reagerer | Tiden ligger inden for grænsen | N/A | N/A
5 Systemet | antages som værende fuldt opsat. Der trykkes på Tænd/-sluk knappen på hoved-enheden og computeren. Når com-puteren er startet op startes CSS programmet. | Tiden ligger inden for grænsen | N/A | N/A
6 | Ikke testbart | N/A | N/A | N/A
7 Systemet | antages som værende fuldt opsat. Babyalarmen udsættes for et lyd-tryk ved at klappe kontinuert i 5 sekunder | ??? | N/A | N/A

IHA - Aarhus Universitet

...fortsat fra forrige side
Punkt | Test | Forventet Resultat | Resultat | Godkendt/ Kommentar
8 Systemet | antages som værende fuldt opsat. Et X10 ud-tag koblet op på syste-met fjernes. Adressen aflæses og en ny en-hed sættes i systemet med samme adresse. | Det er muligt at kontrollere den nye enhed uden at ændre opsætning i systemet. | N/A | N/A
9 Systemet | opsættes i et testmiljø som reflek-tere den almindelige bruger ved at udføre UC7 | Systemet fungerer | N/A | N/A
10 Systemet | antages som værende fuldt opsat. Et nyt X10 udtag opsæt-tes ved at udføre UC8 | X10 udtaget vir-ker med systemet | N/A | N/A
11 Testet under | punkt 9 | N/A | N/A | N/A
12 Systemet | antages som værende fuldt opsat. ?? | ?? | N/A | N/A
13 Testet under | punkt 7 | N/A | N/A | N/A

Gruppe 1 | 5. Accepttestspecifikation

...fortsat fra forrige side
Punkt | Test | Forventet Resultat | Resultat | Godkendt/ Kommentar
14 | Testes ikke på grund af begræns-ninger i systemet, se sektion 3.4 | | N/A | N/A
15 Systemet | antages som værende fuldt opsat. UC2 og UC3 udføres på et opsat X10 udtag | Visueltest: En LED indikator viser at enhenden er aktiv | N/A | N/A
16 Testet under | punkt punkt 9 | N/A | N/A | N/A
17 Systemet | antages som værende fuldt opsat. ?? | ?? | N/A | N/A
18 | Testes ikke på grund af begræns-ninger i systemet, se sektion 3.4 | N/A | N/A | N/A
19 | Testes ikke på grund af begræns-ninger i systemet, se sektion 3.4 | | N/A | N/A

# System Arkitektur 6
