mickkn/E2PRJ2/Projektdokumentation/billeder/cmdprompt/CSS_startopsaetning.png

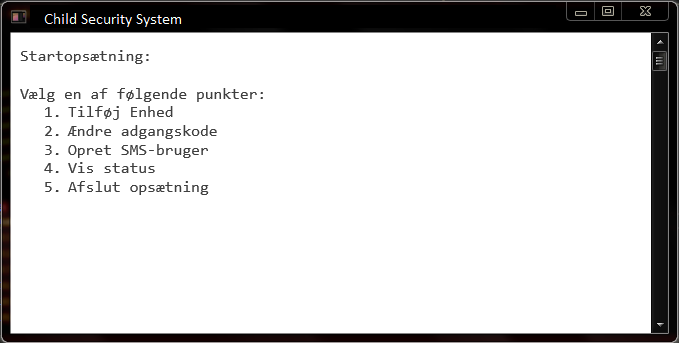
Projektdokumentation/billeder/cmdprompt/CSS_startopsaetning.png
