mickkn/E2PRJ2/Projektdokumentation/billeder/diagrammer/Kontekst_Diagram.png

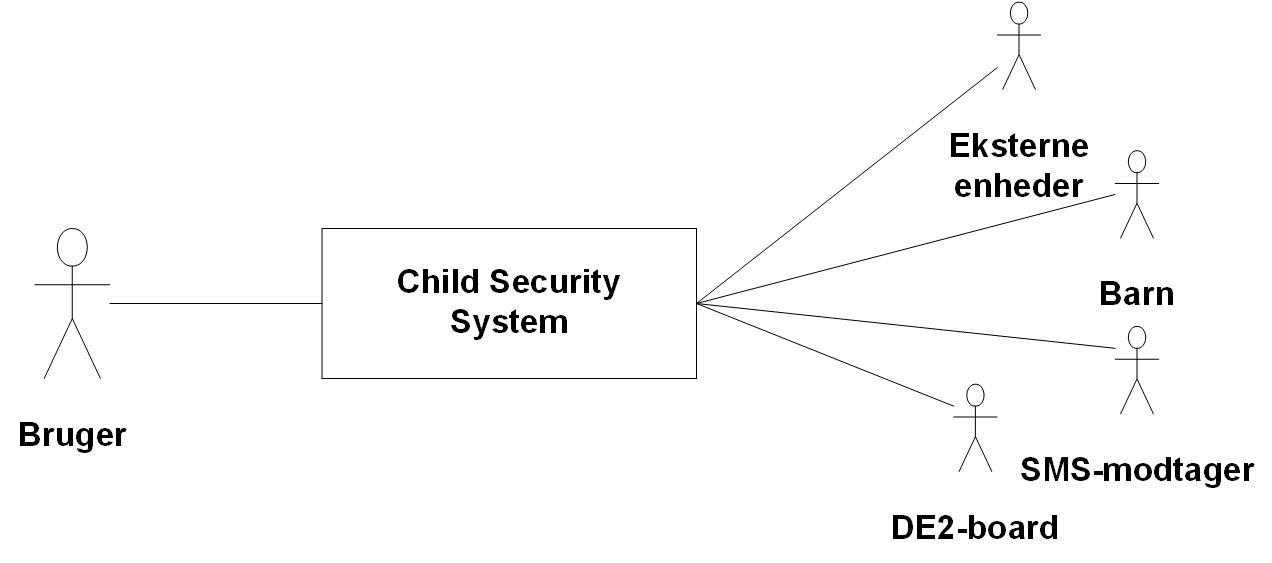
Projektdokumentation/billeder/diagrammer/Kontekst_Diagram.png
