mickkn/E2PRJ2/Projektdokumentation/billeder/GSM_Arduino.png

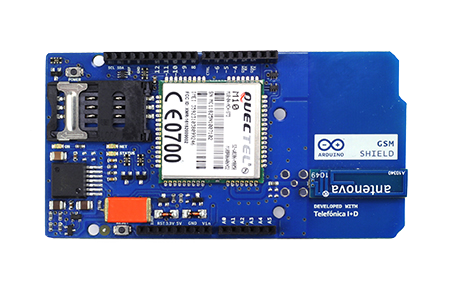
Projektdokumentation/billeder/GSM_Arduino.png
