mickkn/E2PRJ2/Projektdokumentation/billeder/GSM_Clickatell.png

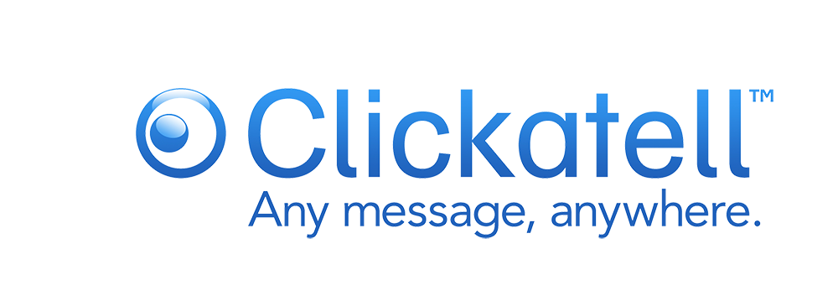
Projektdokumentation/billeder/GSM_Clickatell.png
