mickkn/E2PRJ2/Projektdokumentation/billeder/GSM_TC65I.png

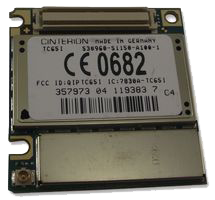
Projektdokumentation/billeder/GSM_TC65I.png
