mickkn/E2PRJ2/Projektdokumentation/billeder/UML/CSS_X10IF_getBit_SD.png

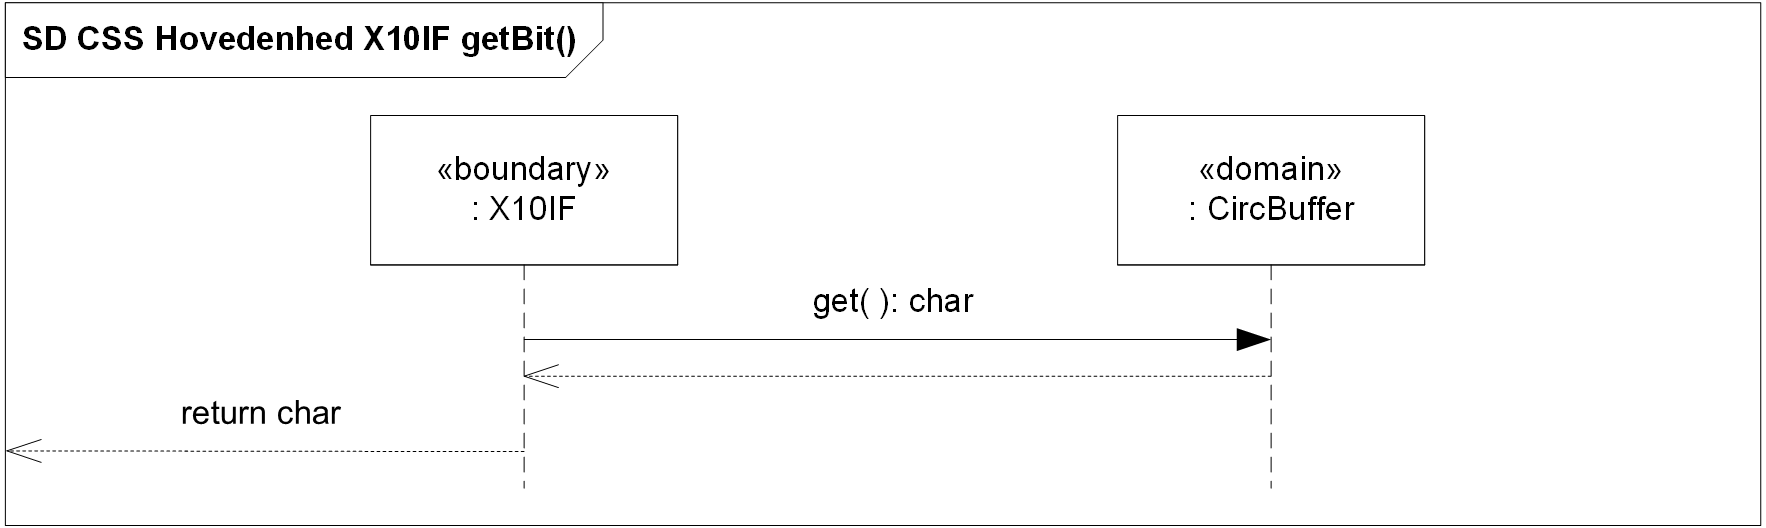
Projektdokumentation/billeder/UML/CSS_X10IF_getBit_SD.png
