mickkn/E2PRJ2/Projektrapport/Billeder/HWdesign/LP_KURVE.png

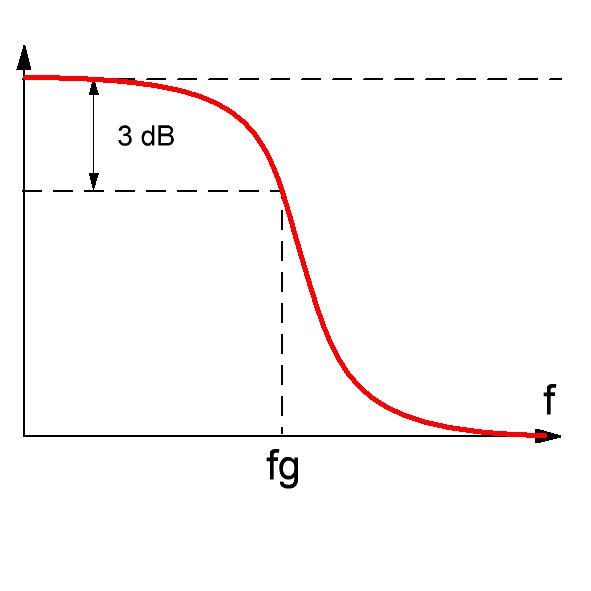
Projektrapport/Billeder/HWdesign/LP_KURVE.png
