mickkn/E2PRJ2/Projektrapport/Billeder/HWdesign/LP_MV.png

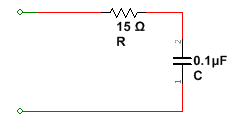
Projektrapport/Billeder/HWdesign/LP_MV.png
