mickkn/E2PRJ2/Projektrapport/Billeder/HWdesign/LP_UV.png

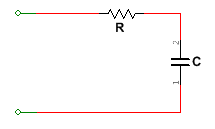
Projektrapport/Billeder/HWdesign/LP_UV.png
