mickkn/E2PRJ2/Projektrapport/Billeder/HWTest/Encoder/Encoder_50Hz.png

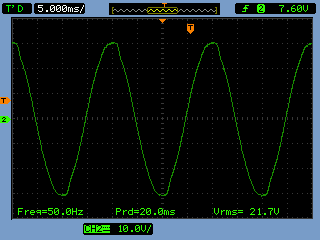
Projektrapport/Billeder/HWTest/Encoder/Encoder_50Hz.png
