mickkn/E2PRJ2/Projektrapport/Billeder/Photo 23-05-14 12.31.58.jpg

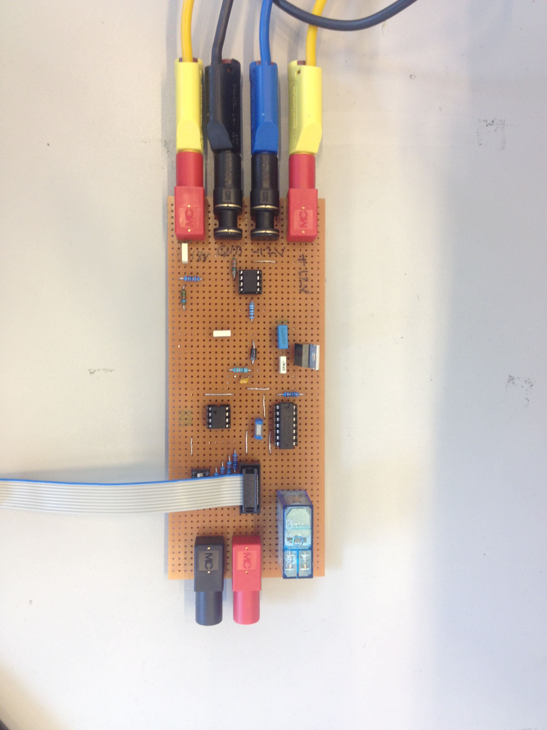
Projektrapport/Billeder/Photo 23-05-14 12.31.58.jpg
