mickkn/E2PRJ2/Projektrapport/filer/resultater.tex

\chapter{Resultater}
Resultatet af denne opgave er endt ud i en prototype af Child Security Systemet, dokumentationen af dette system, samt denne rapport omhandlende systemet.  

Igennem en velstruktureret arkitektur er det lykkedes at udarbejde et system som kan udføre de ønskede opgaver. Disse opgaver udføres af systemet dels gennem RS232 kommunikation mellem PC og CSS-hovedenhed og dels med X10 kommunikation mellem CSS-hovedenhed og X10-udtag. User-interfacet har opnået et flow som specificeret i arkitekturen. 
Prototypen er opbygget på veroboards, disse ses på nedenstående figure \ref{fig:encoder_vero} og \ref{fig:decoder_vero}. Først er der udarbejdet printudlæg for hhv. encoder og decoder, disse er herefter produceret i loddelab. 

\begin{figure}[htb]
  \begin{minipage}{0.5\textwidth}
    \centering
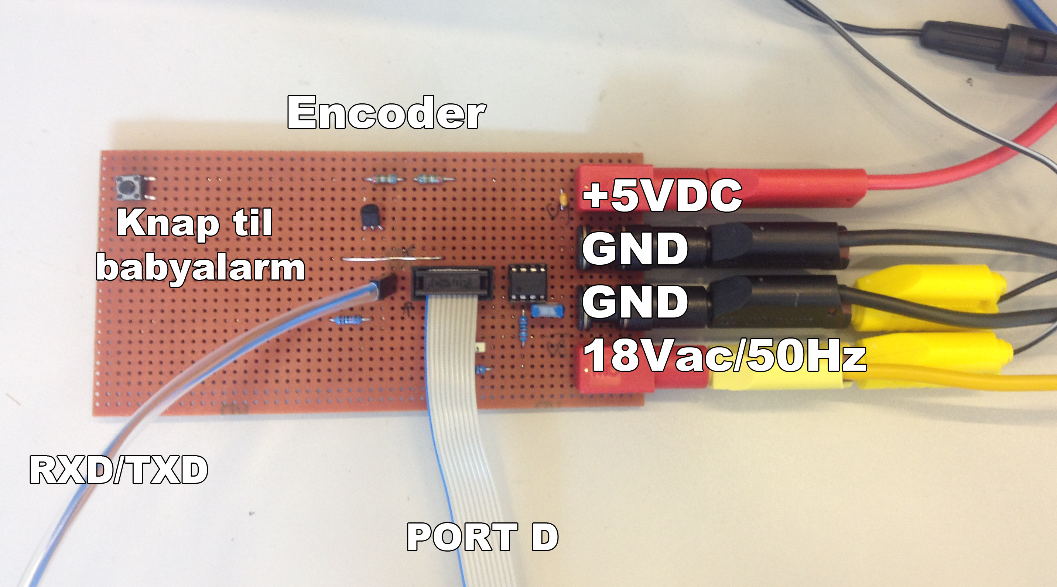
[picture p94: Projektrapport/Billeder/encoderveroboard.png]
      
      \caption{Encoder print}
    \label{fig:encoder_vero}
  \end{minipage}
  \hspace{0.1\textwidth}
  \begin{minipage}{0.5\textwidth}
    \centering
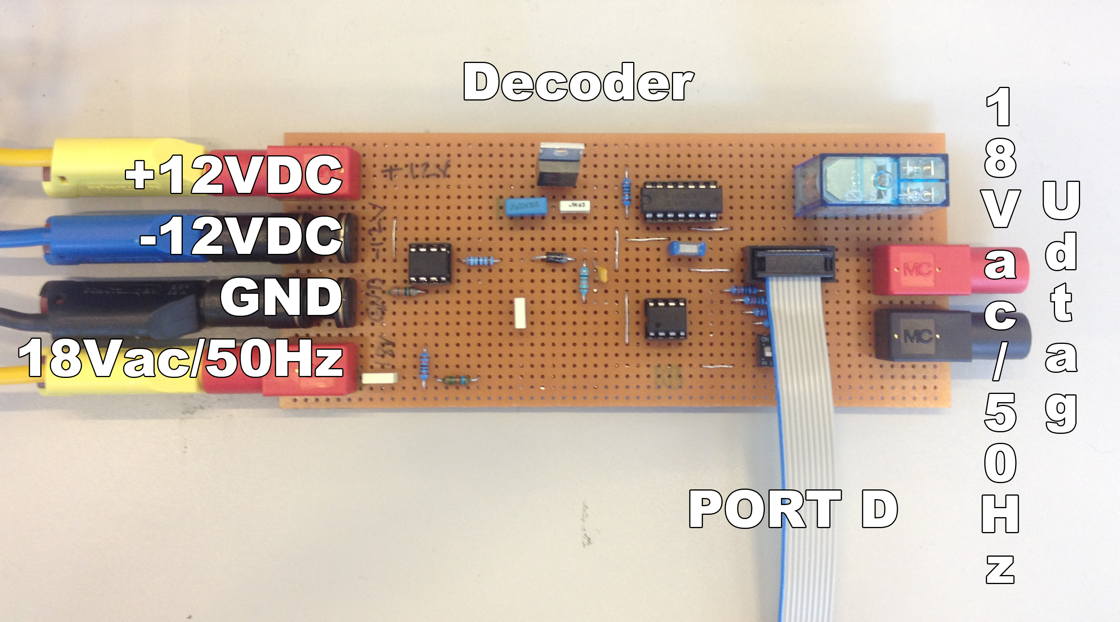
[picture p95: Projektrapport/Billeder/decoderveroboard.png]
      
      \caption{Decoder print}
    \label{fig:decoder_vero}
  \end{minipage}
\end{figure}

Det er ikke lykkedes at få X10-udtag softwaren til at modtage X10-bitstrømmen, derfor er der taget et scopebillede af bitstrømmen med oscilloscope indstillingen single sweep. Ses på figur \ref{fig:Scop_test}.

\begin{figure}[htbp]
  \centering
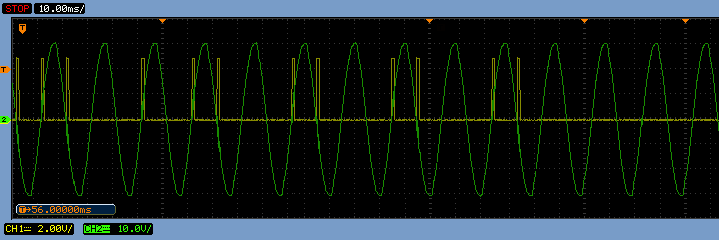
[picture p96: Projektrapport/Billeder/Modtager_0101_ON.png]
    
    \caption{Scopebillede af et testsignal}
    \label{fig:Scop_test}
\end{figure}

Babyalarmens advarsels-SMS, kommer som en flash SMS. Dvs. SMSen vises direkte på skærmen for brugeren, herved kan det ikke undgås at brugeren ser beskeden, når mobilen tages i brug. Skærmbilledet som møder SMS-modtageren, på en iPhone, vil se ud som på figur \ref{fig:flashSMS}
 
\begin{figure}[htbp]
  \centering
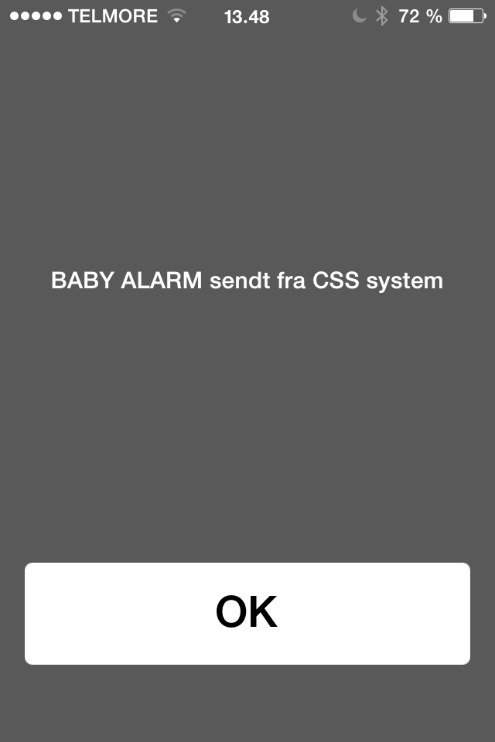
[picture p97: Projektrapport/Billeder/flashSMS.png]
    
    \caption{Flash SMS}
    \label{fig:flashSMS}
\end{figure}
 
RS232 kommunikationen virkede rigtig godt efter der blev gennemført modul test både på RS232IF klassen på PC og CSS-hovedenhed. Modultest kan ses i rapport dokumentationen\footnote{Hhv. side 98 og 100 i projektdokumentationen}.
