mickkn/E2PRJ2/Projektdokumentation/filer/test/SWmodultest.tex

\section{SW Modultest}
Her følger modultest af en del af softwaren. De enkelte testprojekter i deres respektive udviklingsmiljøer ligger også under ''SW Kildekode'' i bilag i mapperne ''Test programmer''.

\subsection{PC RS232IF (JC)}
\input{filer/test/Modultest_PC}

\clearpage

\subsection{CSS-hovedenhed klasser (BS)}
\input{filer/test/Modultest_CSS}
