mickkn/E2PRJ2/Projektdokumentation/filer/test/Modultest.tex

\chapter{Modultest}

\input{filer/test/HWmodultest}

\input{filer/test/SWmodultest}
