mickkn/E2PRJ2/CD Root/Tidsplan.pdf

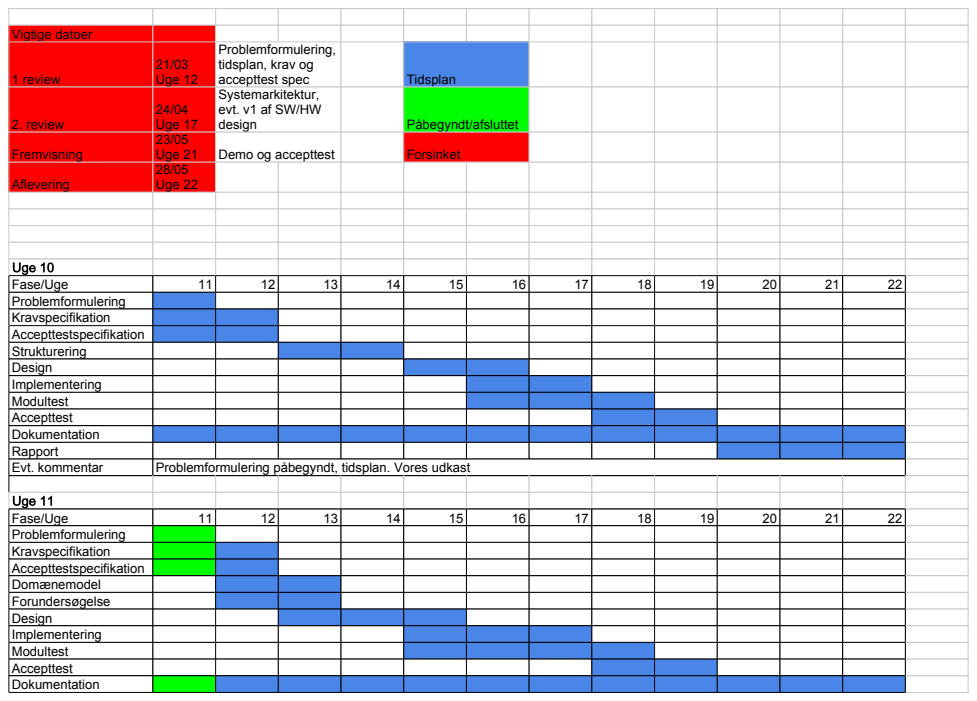
[picture p119: page 1]

Vigtige datoer
1 review | 21/03 Uge 12 | Problemformulering, tidsplan, krav og accepttest spec | Tidsplan

2. review | 24/04 Uge 17 | Systemarkitektur, evt. v1 af SW/HW design | Påbegyndt/afsluttet

Fremvisning | 23/05 Uge 21 | Demo og accepttest | Forsinket

Aflevering | 28/05 Uge 22

Uge 10
Fase/Uge | 11 | 12 | 13 | 14 | 15 | 16 | 17 | 18 | 19 | 20 | 21 | 22
Problemformulering
Kravspecifikation
Accepttestspecifikation
Strukturering
Design
Implementering
Modultest
Accepttest
Dokumentation
Rapport
Evt. kommentar | Problemformulering påbegyndt, tidsplan. Vores udkast

Uge 11
Domænemodel
Forundersøgelse

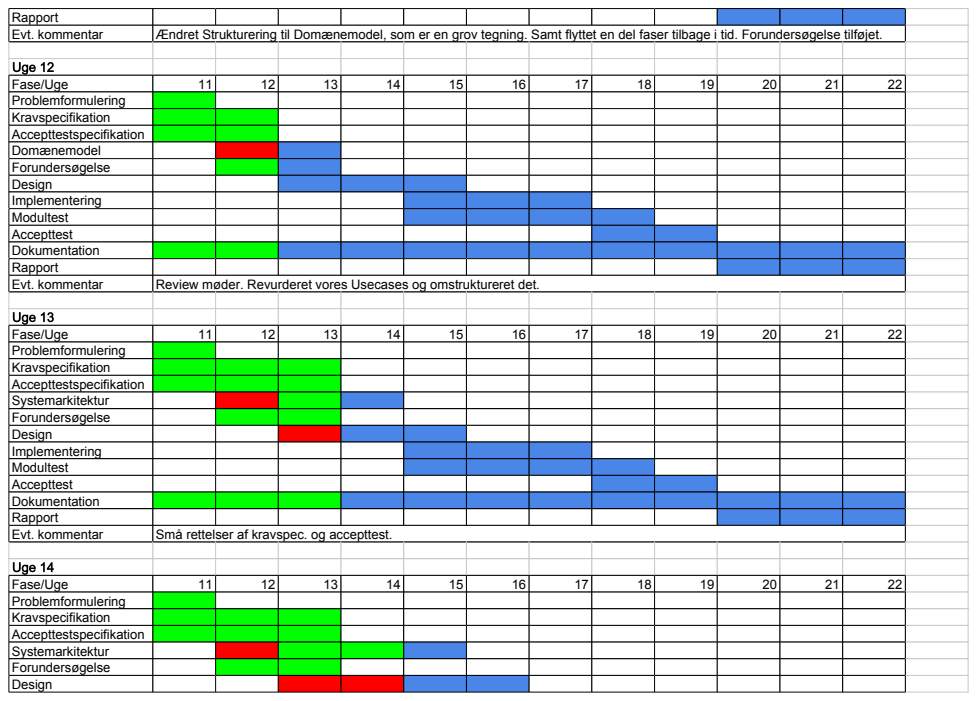
[picture p120: page 2]

Rapport
Evt. kommentar | Ændret Strukturering til Domænemodel, som er en grov tegning. Samt flyttet en del faser tilbage i tid. Forundersøgelse tilføjet.

Uge 12
Fase/Uge | 11 | 12 | 13 | 14 | 15 | 16 | 17 | 18 | 19 | 20 | 21 | 22
Problemformulering
Kravspecifikation
Accepttestspecifikation
Domænemodel
Forundersøgelse
Design
Implementering
Modultest
Accepttest
Dokumentation
Evt. kommentar | Review møder. Revurderet vores Usecases og omstruktureret det.

Uge 13
Systemarkitektur
Evt. kommentar | Små rettelser af kravspec. og accepttest.

Uge 14

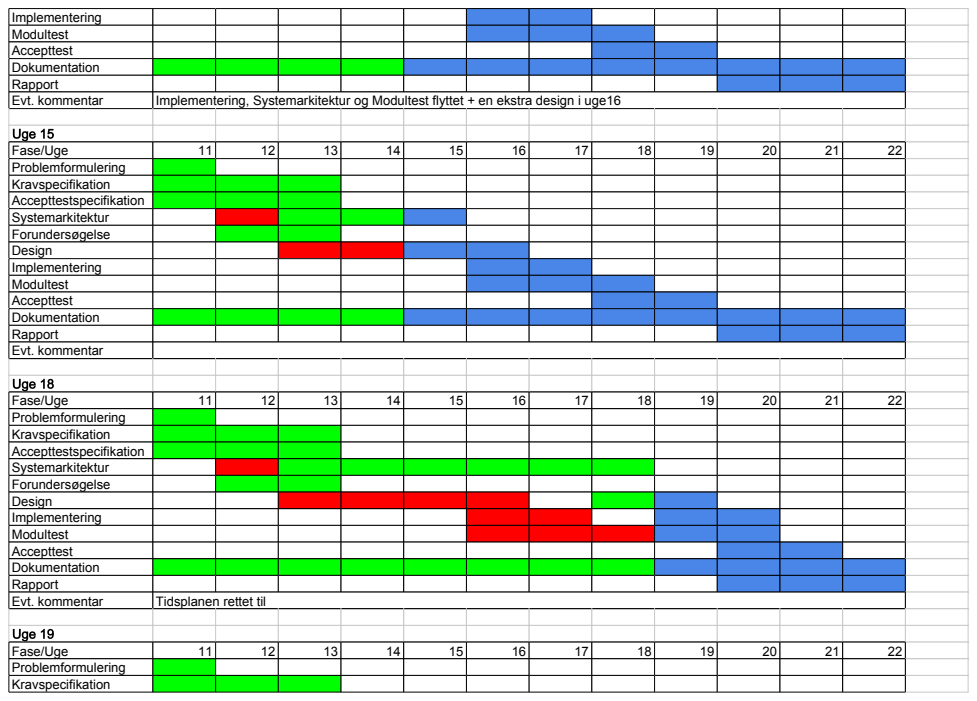
[picture p121: page 3]

Implementering
Modultest
Accepttest
Dokumentation
Rapport
Evt. kommentar | Implementering, Systemarkitektur og Modultest flyttet + en ekstra design i uge16

Uge 15
Fase/Uge | 11 | 12 | 13 | 14 | 15 | 16 | 17 | 18 | 19 | 20 | 21 | 22
Problemformulering
Kravspecifikation
Accepttestspecifikation
Systemarkitektur
Forundersøgelse
Design
Evt. kommentar

Uge 18
Evt. kommentar | Tidsplanen rettet til

Uge 19

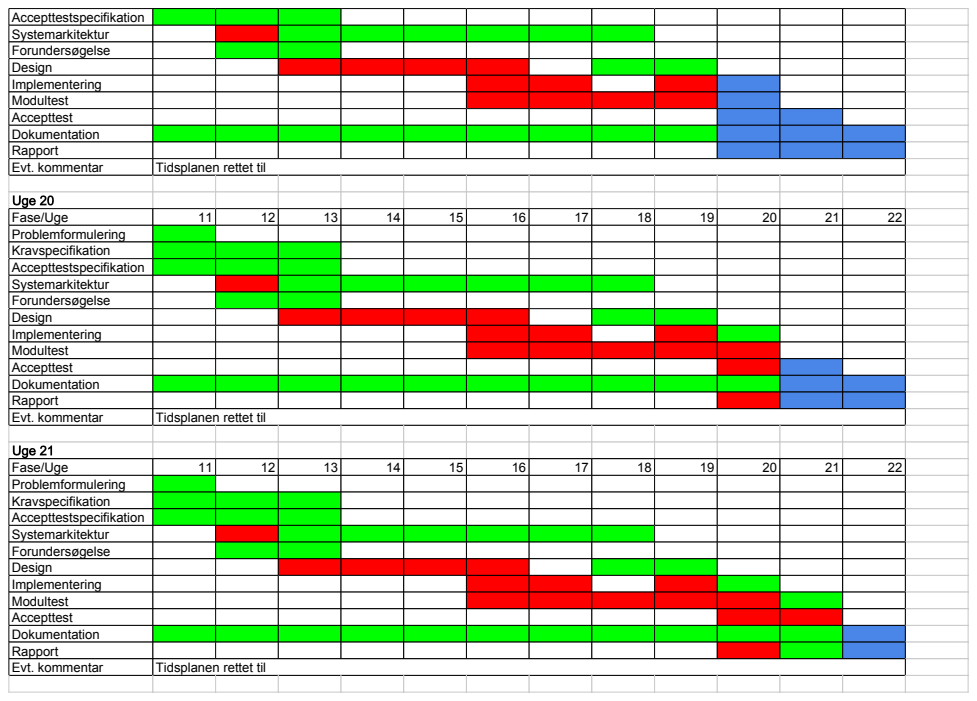
[picture p122: page 4]

Accepttestspecifikation
Systemarkitektur
Forundersøgelse
Design
Implementering
Modultest
Accepttest
Dokumentation
Rapport
Evt. kommentar | Tidsplanen rettet til

Uge 20
Fase/Uge | 11 | 12 | 13 | 14 | 15 | 16 | 17 | 18 | 19 | 20 | 21 | 22
Problemformulering
Kravspecifikation

Uge 21

Uge 22
Fase/Uge | 11 | 12 | 13 | 14 | 15 | 16 | 17 | 18 | 19 | 20 | 21 | 22
Problemformulering
Kravspecifikation
Accepttestspecifikation
Systemarkitektur
Forundersøgelse
Design
Implementering
Modultest
Accepttest
Dokumentation
Rapport
Evt. kommentar | Tidsplanen rettet til
