mickkn/E2PRJ2/(list of files, drawings)

Other design files:
Design/Hardware/baandpas.ms12
Design/Hardware/BabyAlarm_Switch.ms12
Design/Hardware/Decoder v2.ms12
Design/Hardware/Decoder.ms12
Design/Hardware/Encoder.ms12
Design/Hardware/Envelope.ms12
Design/Hardware/HP filter.ms12
Design/Hardware/Samlet encoder decoder.ms12
Design/Hardware/Udtag.ms12
