mickkn/E2PRJ2/CD Root/SW Kildekode/CSS-hovedenhed/Atmel Studio projekt/Main program/UC5DetekterLyd.h

/*
 * Controller UC5DetekterLyd
 *
 * Af Bjørn Sørensen
 */ 


#pragma once

#include "RS232IF.h"

class UC5DetekterLyd
{
public:
	UC5DetekterLyd(RS232IF *);
	
	void detekterLyd( );
private:
	RS232IF * RS232Ptr_;
	
};
