mickkn/E2PRJ2/CD Root/SW Kildekode/PC/Microsoft Visual Studio projekt/Main program/ClickATellIF.cpp

#pragma once

#include"ClickATellIF.h"
#include<windows.h>
#include<ShellApi.h>

clickATellIF::clickATellIF()
{}

void clickATellIF::sendSMS(int phoneNumber)
{
	string url;

	url.append("http://api.clickatell.com/http/sendmsg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");
	url.append(static_cast<ostringstream*>(&(ostringstream() << phoneNumber))->str());

	ShellExecuteA(NULL, "open", "iexplore.exe", url.c_str(), NULL, 2);
}
