mickkn/E2PRJ2/CD Root/SW Kildekode/PC/Microsoft Visual Studio projekt/Main program/ClickATellIF.h

#pragma once

#include<iostream>
#include<sstream>
#include<string>
#include<windows.h>
#include<ShellApi.h>

using namespace std;


class clickATellIF
{
public:
	clickATellIF();

	void sendSMS(int phoneNumber);

private:
};
