mickkn/E2PRJ2/CD Root/SW Kildekode/PC/Microsoft Visual Studio projekt/Main program/DetekterLyd.h

#pragma once

//#include "clickATellIF.h"
#include "hukommelse.h"

class detekterLyd
{
public:
	detekterLyd(/*clickATellIF *,*/ hukommelse *);
	void lydDetekteret();

private:
	//clickATellIF * smsPtr;
	hukommelse * huPtr;
};
