mickkn/E2PRJ2/CD Root/SW Kildekode/PC/Microsoft Visual Studio projekt/Main program/detekterLyd.cpp

#include "detekterLyd.h"

detekterLyd::detekterLyd(/*clickATellIF * click,*/ hukommelse * hu)
{
	//smsPtr = click;
	huPtr = hu;
}

void detekterLyd::lydDetekteret()
{
	int nummer = huPtr->getNumber();

	//smsPtr->sendSMS(nummer);

}
