mickkn/E2PRJ2/CD Root/SW Kildekode/PC/Microsoft Visual Studio projekt/Main program/deaktiver.h

#pragma once

#include "RS232IF.h"
#include "brugerUI.h"
#include "hukommelse.h"

class deaktiver
{
public:
	deaktiver(RS232IF *, hukommelse *, brugerUI *);
	void deaktiverEnhed();

private:
	RS232IF * rsPtr;
	hukommelse * huPtr;
	brugerUI * uiPtr;
};
