mickkn/E2PRJ2/CD Root/SW Kildekode/PC/Microsoft Visual Studio projekt/Main program/redigerSmsBruger.h

#pragma once

#include "brugerUI.h"
#include "hukommelse.h"

class redigerSmsBruger
{
public:
	redigerSmsBruger(hukommelse *, brugerUI *);
	void redigerSMS();

private:
	hukommelse * huPtr;
	brugerUI * uiPtr;
};
