mickkn/E2PRJ2/CD Root/SW Kildekode/CSS-hovedenhed/Test programmer/UART/UART/UART Test.cpp

/*
 * Test program
 *
 * RS232IF og UART driver
 *
 * Af Bjørn Sørensen
 *
 */

#define F_CPU 3686400
#include <avr/io.h>
#include <util/delay.h>
#include <stdlib.h>

#include "UART.h"


int main()
{
	// Initialiser kommando buffer
	dataCount = 0;
	commandReady = 0;
	
	// Initialiser port B til output og sluk LEDer 
	DDRB = 0xFF;
	PORTB= 0xFF;

	// Send string
	char string[] = "CSS hovedenhed\r\n";
	RS232UART.sendString(string);
	
	// Global interrupt enable
	sei();
	
	while(1)
	{
		// Hvis fuld kommando er klar
		if(commandReady == 1)
		{
	
			// Returner modtaget kommando
			for( unsigned char i = 0; i < COMMAND_SIZE; i++ )
				RS232UART.sendChar(dataIn[i]);

			// Kommando læst, nulstil buffer
			commandReady = 0;
			dataCount = 0;
		}
	}
}
