mickkn/E2PRJ2/CD Root/SW Kildekode/PC/Test programmer/rs232IF/rs232IF/rs232IF.h

#pragma once

#include "Serial.h"
#include <string>

#define port 4
#define commandSize 7

using namespace std;

class RS232IF
{
public:
	RS232IF();
	~RS232IF();
	bool validLogin();
	bool aktiver(int);
	bool deaktiver(int);
	int read();
	bool tester(string);

private:
	CSerial serial;
};
