mickkn/E2PRJ2/(commit log)

2014-03-10 Sync test :)
    Fordi det driller Simon!
2014-03-12 Use Case 2 Skrevet
2014-03-13 UC1 og ATUC1 oprettet
    Use case 1 beskrivelse og accept test af use case 1 oprettet
2014-03-17 Nyt sidenummer
    Ingen ved hvorfor…
2014-03-19 Versions nummer i kravspec + rettet enumerate i dem der manglede
2014-03-21 1. Review klargørings ændringer
    UC og Kontekst diagrammer opdateret.
    Accepttest bruger nu Longtable med fortsat Header hvis det fylder mere
    end en side, eller skal fortsætte på næste. Den skriver automatisk
    “Fortsat fra forrige side” dette er ikke gældende ved Usecase’s (kan
    laves hvis det blir nødvendigt.)
    Aktørbeskrivelser lavet. Overvejer lidt om SMS-modtager måske er Bruger?
    Aktiver og Deaktiver er ikke færdige.
    Brug Usecase diagrammet til at skrive jeres Usecases via. Mht. aktører.
    Ved “Aktør” punktet i UC, brug Aktørnavn(Position) f.eks.
    Bruger(Primær) etc.
    Ved UC5: Detekter Lyd har jeg smidt advisering i comment under den
    gamle UC beskrivelse. Til evt. ge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
2014-03-25 BDD Version 0.25
    Lille opdatering, for at se hvad der ellers blir lavet
2014-03-26 BDD encoder
    Udkast til et BDD encoder
2014-04-03 BDD Hardware 1.0
    Rettet linjer :) så nu er de lige.
2014-04-04 IBD X10 sender/modtager
    Har tegnet det ind vi blev enige om på tavlen, der kommer nok rettelser
    til signal navne ??
2014-04-08 UC8, X10 modtager appmodel oprettet, CSS opdateret
    UC8 opdateret så der er mulighed for at fjerne enheder. AT opdateret i
    henhold til det.
    X10 modtager applikationsmodel oprettet.
    CSS hovedenhed applikationsmodel opdateret.
2014-05-01 UC6
    tilføjet beskrivelse af hvad der ændres. -> telefonnummer
2014-05-01 Applikationsmodel diagrammer og UC1 opdatering
    Applikationsmodel diagrammer i høj opløsning og UC1 opdateret til at
    bruge DE2 board
2014-05-02 Multisim (Encoder/Decoder)
    Multisim tegning over encoder/decoder, dog ikke med de rigtige komponent
    størrelser
    [Decoder.ms12, Encoder.ms12]
2014-05-03 Porte på Plantegning
    [Decoder.ms12, Encoder.ms12]
2014-05-07 Decoder/encoder opdateret
    med udregnet komponent værdier
    [Decoder.ms12, Encoder.ms12, Samlet encoder decoder.ms12]
2014-05-13 SW: CSS UART driver
    Low-level UART driver til STK500
2014-05-13 SW CSS: UART og RS232IF
    UART næsten komplet.
    RS232IF påbegyndt med protokollen
2014-05-13 SW CSS UART klasse færdig
    HW UART driver til STK500-kit færdig og testet.
2014-05-13 SW CSS: RS232IF
    Kommunikation virker, dog med nogle protokol dekodnings bugs.
    [RS232IF Test.cpp, RS232IF.cpp, RS232IF.h, UART.cpp, UART.h]
2014-05-14 Encoder Scope billeder
    Efter Bjørn’s STK burst program
2014-05-14 Tekst/rettelser til BDD/IBD/decoder og encoder
    Skrevet tekst til alle BDD og IBD, samt rettet diverse parts/navne.
    Rettet enkelte komponenter i encoder/decoder.
    [Decoder.ms12, Encoder.ms12]
2014-05-14 Protokol opdateret
    RS232: Dummy adresse tilføjet
    Fælles: <cr> ændret til ASCII notationen \r alle steder.
    Carriage Return tilføjet på ordlisten.
2014-05-14 rettelser decoder
    [Decoder.ms12]
2014-05-14 filer der ikke committer første gang wtf -.-
2014-05-17 lille rettelse i stm/flowchart
2014-05-18 Revert "Git hub fucker. committer ALT i repos."
    This reverts commit fe6344907a6471f48d1b3bb7f7d901ec4ba01b02, reversing
    changes made to 5318fa2fdc83e5f213b60bcc02a13ae8fe85a09f.
    Conflicts:
    Implementering/SW PC/TEST/test/test.sdf
    Implementering/SW PC/TEST/test/test.v11.suo
    Implementering/SW PC/TEST/test/test/Login.cpp
    Implementering/SW PC/TEST/test/test/tester.cpp
    Projektdokumentation/Master.pdf
    Projektdokumentation/filer/HWbeskrivelse.tex
    Projektdokumentation/filer/protokol/rs232.tex
    Projektdokumentation/filer/protokol/x10.tex
    [Decoder.ms12, Encoder.ms12]
2014-05-18 sync af noget kode som gik galt ved revert
    [DetekterLyd.h, Login.cpp, aktiver.cpp, aktiver.h, brugerUI.cpp, brugerUI.h, deaktiver.cpp, deaktiver.h]
2014-05-18 SW CSS: ZeroCross interrupt done
    ZeroCross interrupt er lavet og testet så godt det var muligt uden et
    storrage scope.
    Opdateret X10IF Test kommentare så den indeholder testbeskrivelsen
2014-05-18 den vil ikke build. forsøgt debug. virker stadig ikke
    Latex builder ikke.. det revert havde smidt nogle ting ind i de filer
    med conflict.. sku jeg gerne have fået fjernet.
2014-05-18 Der kan buildes igen
    Jeg har endt Jakob’s table’s i HW Beskrivelse
    …samt clearpage inden software sektionen
    Junk deleted
2014-05-19 Møde ændringer
    Indledning flyttet til KravSpec
    DE2 board tilføjet som aktør
    DE2 tilføjet til UC1 Login Kravspec som aktør
    Fikset en Duplicate label i Dataview.tex
2014-05-19 Decoder V2
    [Decoder v2.ms12, Decoder.ms12, Encoder.ms12]
2014-05-20 Decoder V2, Udtag, BDD, plantegning
    Multisimtegning til udtag, rettelser til decoder V2, BDD og plantegning.
    [Decoder v2.ms12, Encoder.ms12, Udtag.ms12]
2014-05-20 SW CSS: Korrigerringer til grundklasser
    Sikring af outputs i timer klassen. Opdateret.
    [Timer.cpp, Timer.h, X10IF.cpp, X10IF.h]
2014-05-20 HW design
    lavet masser lækkert dokumentation på båndpas. det ren snolder!
    [baandpas.ms12]
2014-05-21 Revert f773965..4abe685
    This rolls back to commit f773965d240c06771c8e9202d5d4505a42513f2a.
    [Decoder v2.ms12, Encoder.ms12, Udtag.ms12]
2014-05-21 Decoder V2 relæ
    [Decoder v2.ms12]
2014-05-21 Decoder, nu med udtag og DIP switches
    [Decoder v2.ms12]
2014-05-21 Hw design
    …
    [HP filter.ms12]
2014-05-21 billede af filter kurve
2014-05-21 Scope billede af open relay
2014-05-22 Rettelser (Envelope, Plantegning)
    [Decoder v2.ms12, Envelope.ms12]
2014-05-22 SW PC: Release
    Main program til PC er testet sammen med CSS.
    Rettelser efter commit crash go cleaning af projected.
    [DetekterLyd.h, Login.cpp, aktiver.cpp, aktiver.h, brugerUI.cpp, deaktiver.cpp, deaktiver.h, detekterLyd.cpp]
2014-05-22 DE2 beskrevet
    DE2 Kode tilføjet
    DE2 HW Design skrevet
    DE2 HW Test skrevet
    Fixet nogle LIBPNG warnings
    Div. billeder
    [bin_2_7_seg.vhd, code_lock.vhd]
2014-05-23 Babyalarm switch
    Multisim Tegning
    [BabyAlarm_Switch.ms12]
2014-05-23 projektafgrænsning tilføjet til rapport
    snolder…
2014-05-23 arbejdsproces tilføjet i rapport
    fredagssnolder…
2014-05-23 Decoder opdateret
    [Decoder v2.ms12]
2014-05-25 Footnote fix
    Lavet en CD Root mappe
    [bin_2_7_seg.vhd, code_lock.vhd]
2014-05-25 Use Case + Accepttest rettelser
    Lavet alle UC’s til longtables
    Indsat godkendelser - færdiggøres efter møde på mandag
2014-05-25 fix af projekt settings for main projekt
    [Serial.cpp]
2014-05-27 magnetlås i projekafgrænsning
2014-05-27 Rettelser til encoder/X10 udtag
